valletw/busy-board/busy-board.step

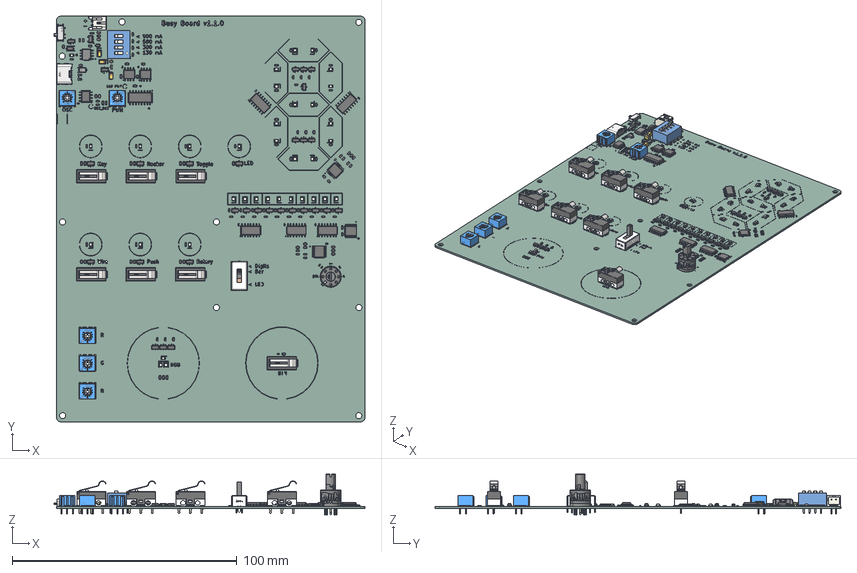
[picture p3: CAD file, 2026-09-27]
busy-board.step
138.2 x 180.3 x 18.1 mm
R_0402_1005Metric x 3
CP_EIA-3216-18_Kemet-A x 3
LED_0805_2012Metric x 35
C_0402_1005Metric x 14
SW-TH_RS-08-300-150GF
SW-TH_RT-0C4-D
R_0603_1608Metric x 108
SOT-23 x 28
TYPE-C-SMD_6P-L8.9-W6.8-H3.2-P1.00
TPD1E05U06DPYR x 2
TP4056-42-ESOP8
SW-TH_DM1-12UP-1-L12.8-W5.8-H11.3-P5.08 x 7
SW-TH_SS-23D06-L5
C_0603_1608Metric x 6
L_0603_1608Metric x 2
SOIC-14_3.9x8.7mm_P1.27mm x 5
D_SOD-123F
BOURNS_3362P x 5
TSSOP-16_4.4x5mm_P0.65mm x 3
SW-SMD_3P-L6.6-W2.7-LS7.8-P1.50
SOT-23-3
D_SMF
SW_DIP_SPSTx04_Slide_9.78x12.34mm_W7.62mm_P2.54mm
JST_PH_S2B-PH-K_1x02_P2.00mm_Horizontal
SOIC-8_3.9x4.9mm_P1.27mm x 3
SOP-16_4.4x10.4mm_P1.27mm
SOT-23-5
D_SOD-323
busy-board_silkscreen
busy-board_PCB
