valletw/busy-board/busy-board.pdf

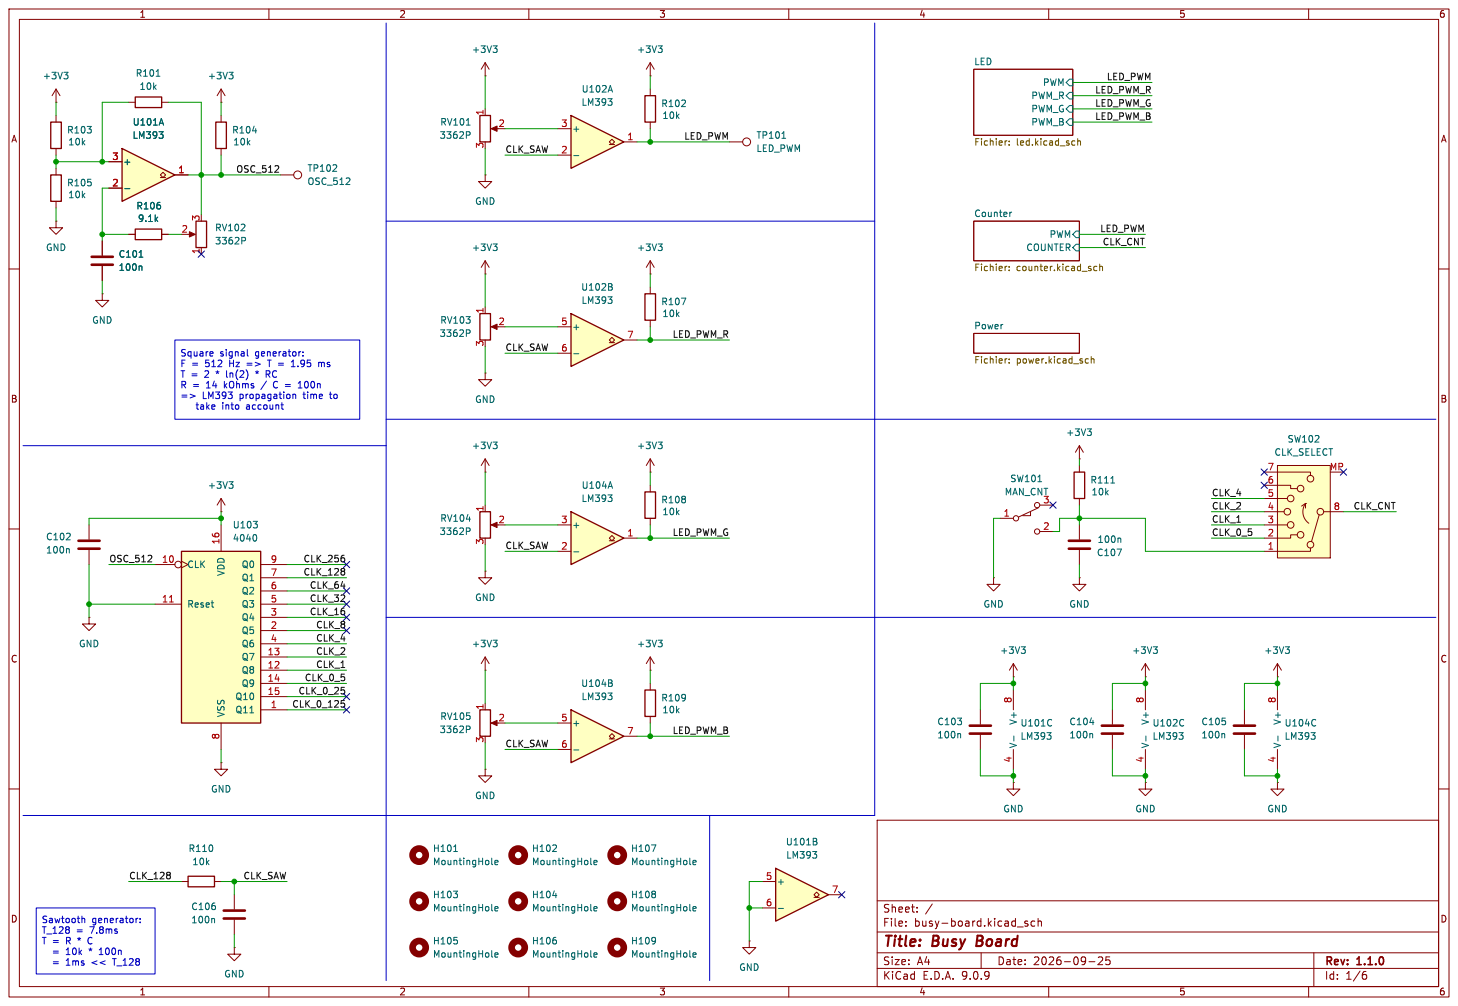
[picture p4: page 1]

LED
Power Fichier: power.kicad_sch PWM

Square signal generator: F = 512 Hz => T = 1.95 ms T = 2 * ln(2) * RC

File: busy-board.kicad_sch Sheet: /
Id: 1/6 Title: Busy Board

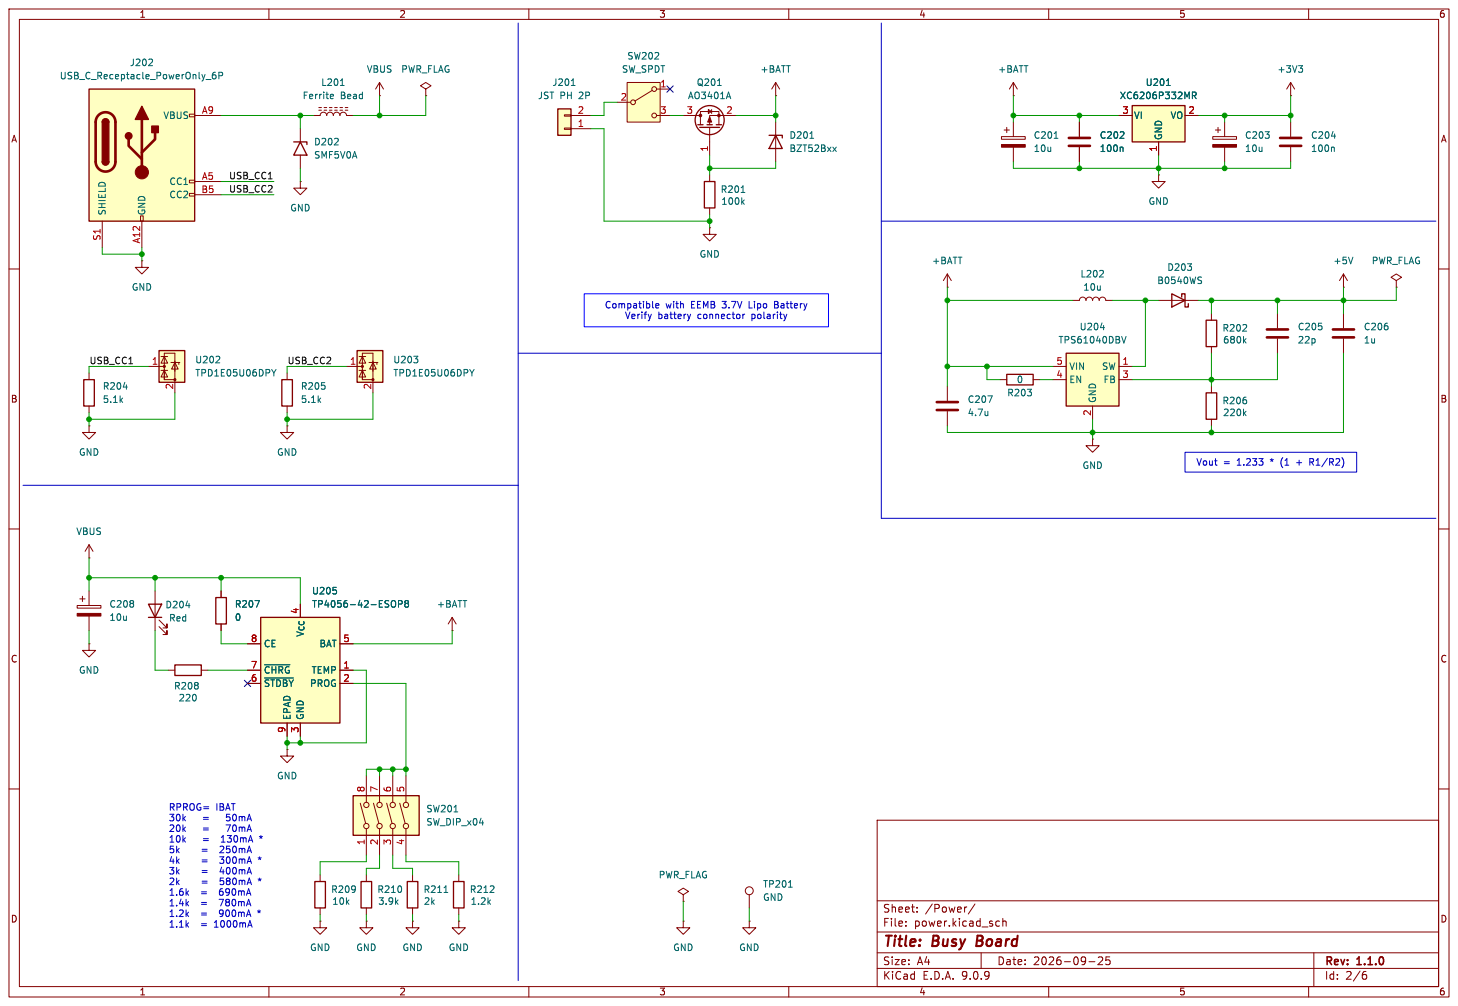
[picture p5: page 2]

File: power.kicad_sch Sheet: /Power/
Id: 2/6 Title: Busy Board

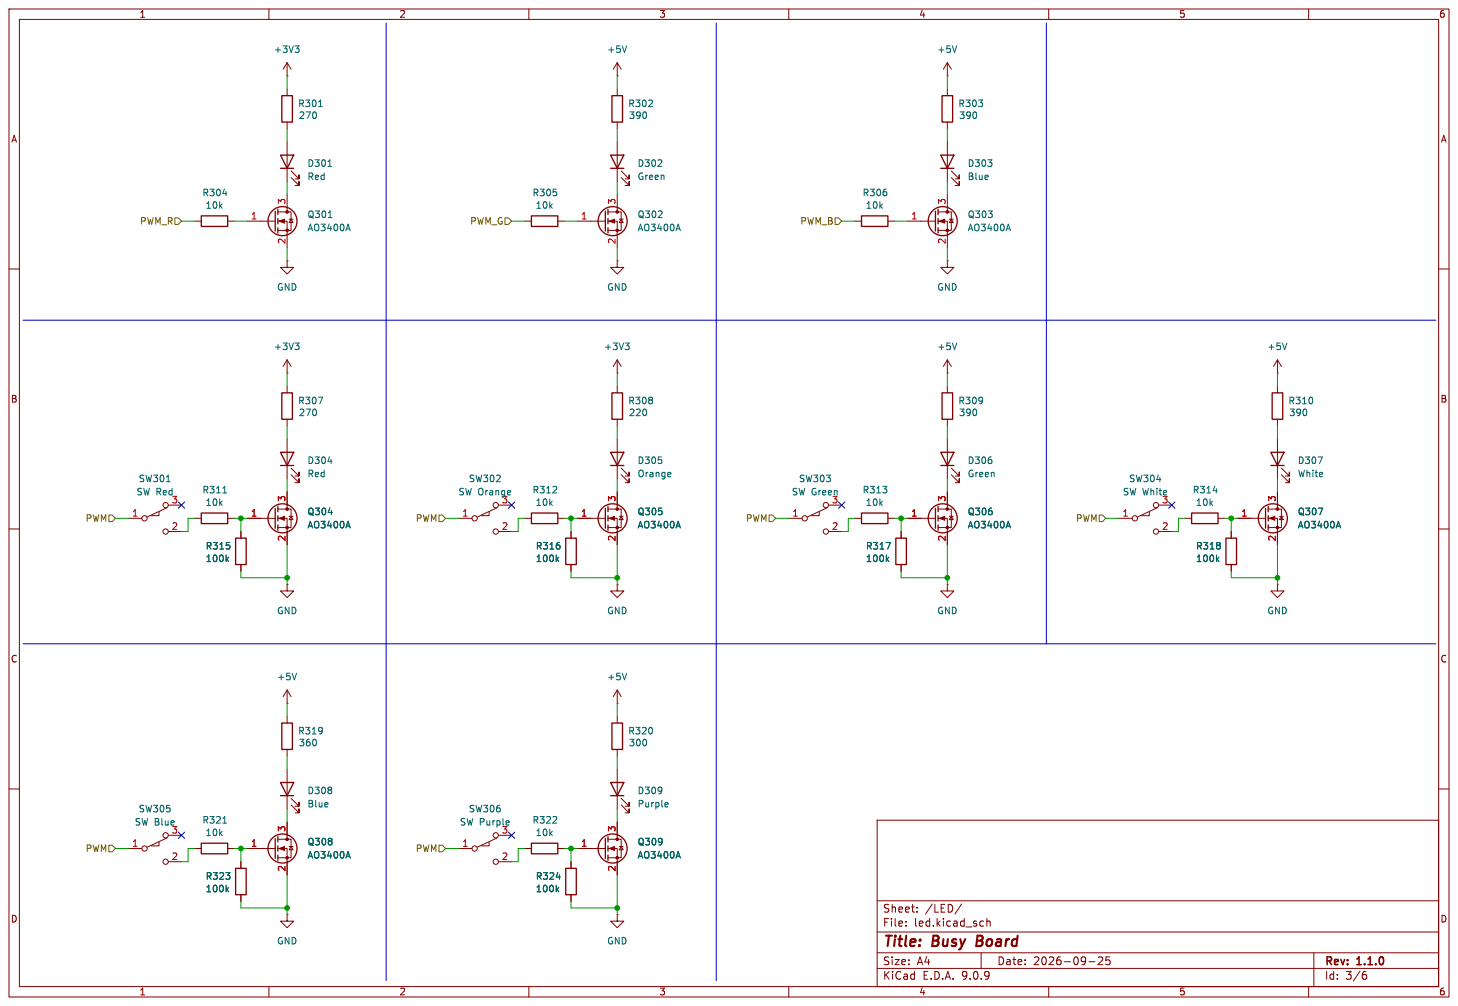
[picture p6: page 3]

File: led.kicad_sch Sheet: /LED/
Id: 3/6 Title: Busy Board

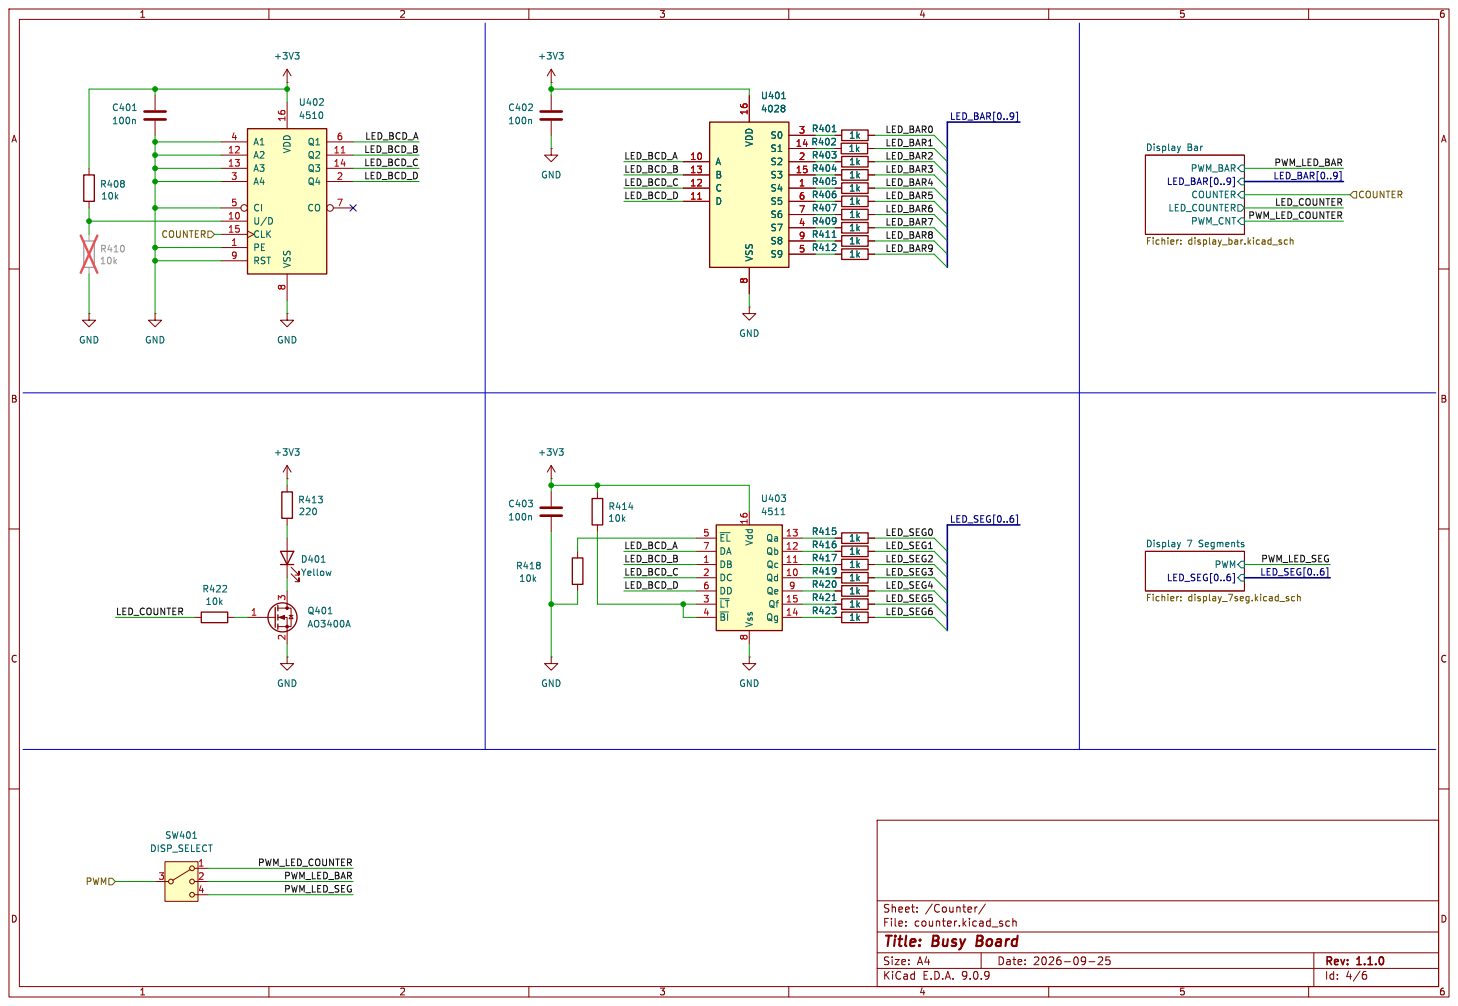
[picture p7: page 4]

PWM_CNT Display Bar Fichier: display_bar.kicad_sch PWM

File: counter.kicad_sch Sheet: /Counter/
Id: 4/6 Title: Busy Board

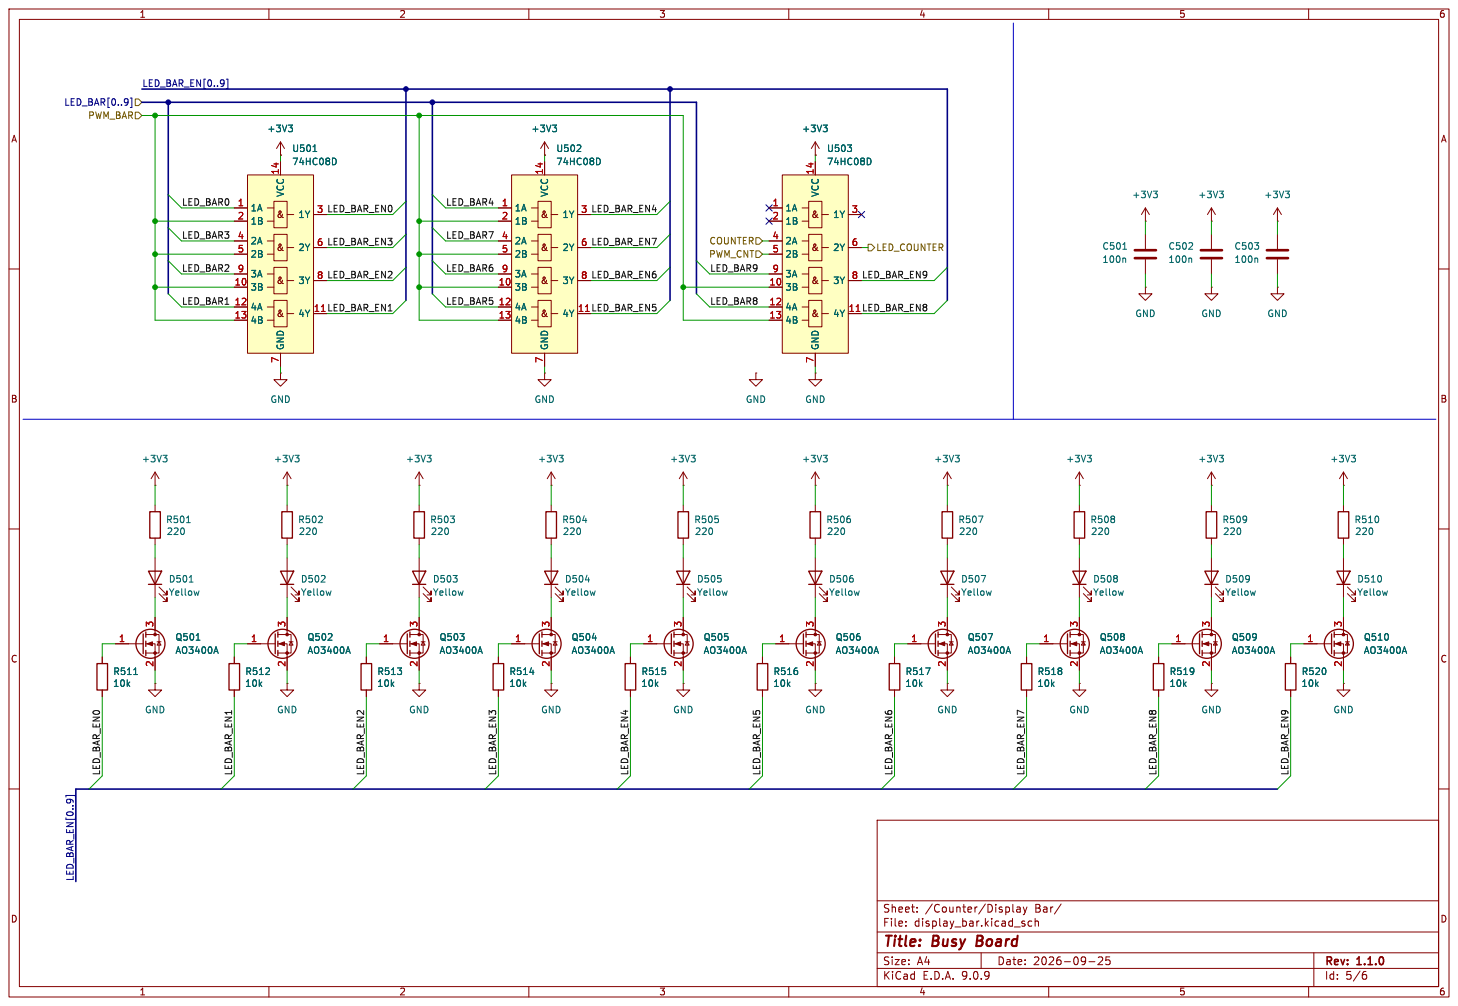
[picture p8: page 5]

Id: 5/6 Title: Busy Board

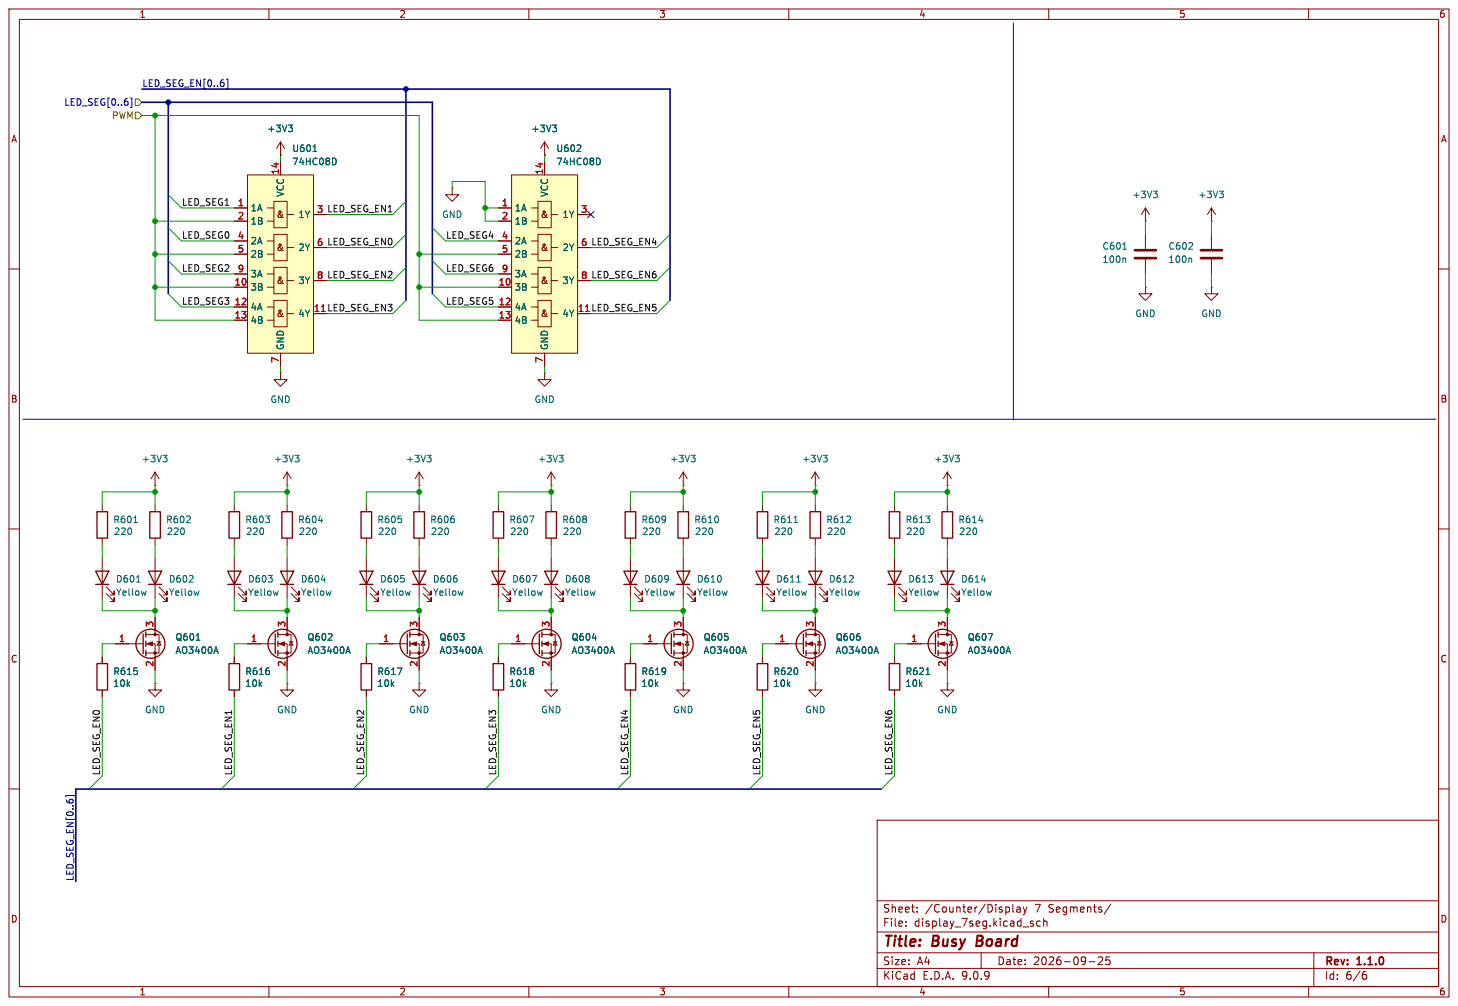
[picture p9: page 6]

Id: 6/6 Title: Busy Board
