valletw/busy-board/kicad/busy-board.kicad_pcb

## KiCad design kicad/busy-board.kicad_pcb (2026-09-27)

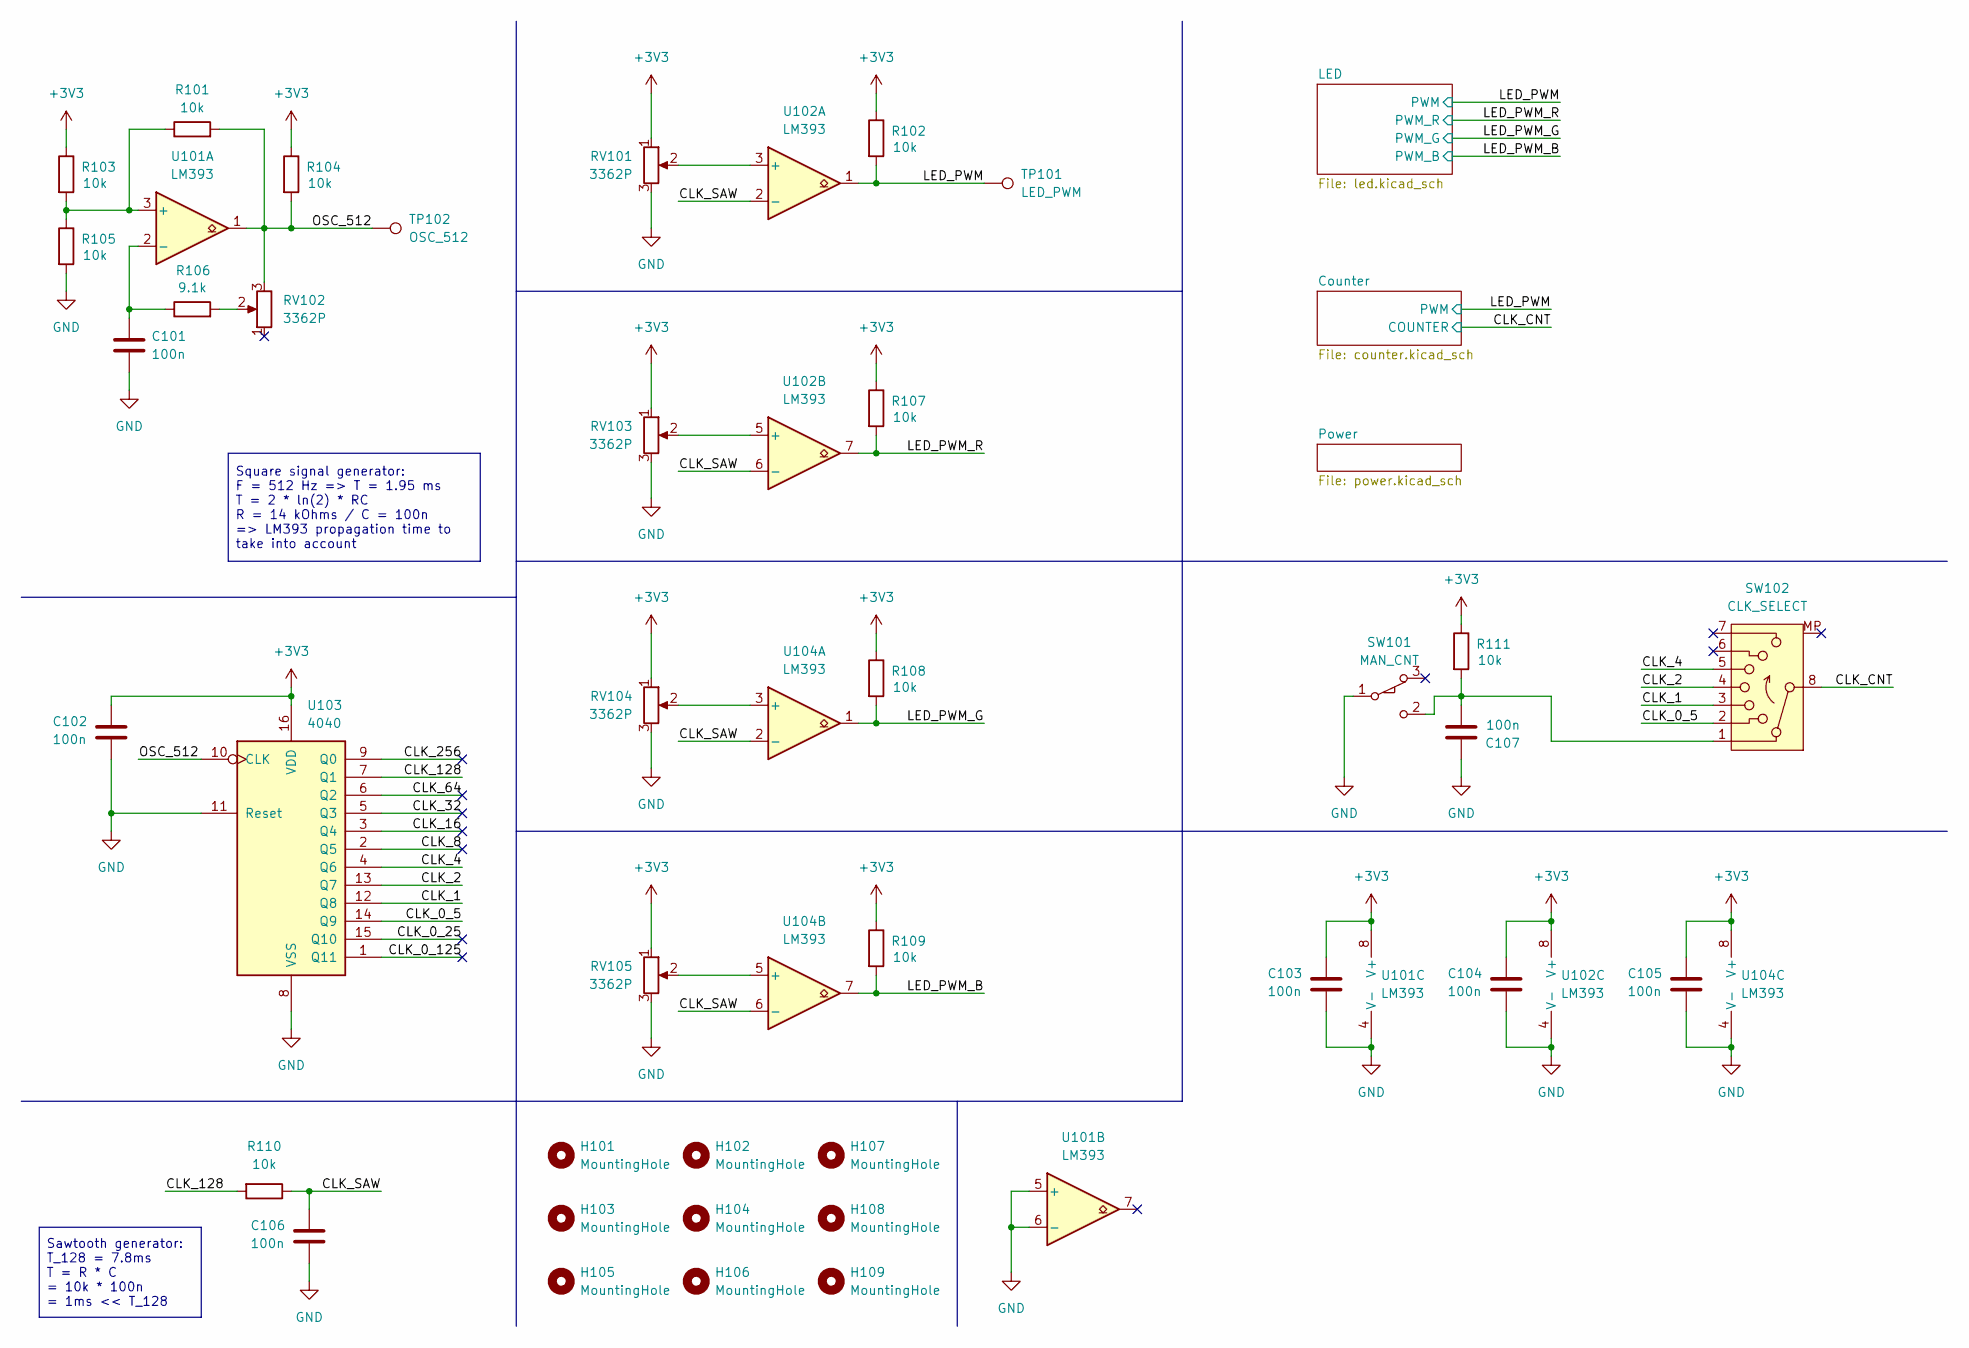
[picture p10: schematic busy-board.kicad_sch, Busy Board]

Parts:
C101: 100n; C_0603_1608Metric; MFR Part # CC0603JRX7R7BB104; LCSC Part # C91183
C102, C103, C104, C105, C106, C107: 100n; C_0402_1005Metric; MFR Part # CL05B104KB54PNC; LCSC Part # C307331
H101, H102, H103, H104, H105, H106, H107, H108, H109: MountingHole; MountingHole_2.7mm_M2.5_ISO7380
R101, R102, R103, R104, R105, R107, R108, R109, R110, R111: 10k; R_0603_1608Metric; MFR Part # 0603WAF1002T5E; LCSC Part # C25804
R106: 9.1k; R_0603_1608Metric; MFR Part # 0603WAF9101T5E; LCSC Part # C23260
RV101, RV102, RV103, RV104, RV105: 3362P; BOURNS_3362P; MFR Part # 3362P-1-103LF; LCSC Part # C58159
SW101: MAN_CNT; SW-TH_DM1-12UP-1; MFR Part # DM1-12UP-1; LCSC Part # C405949
SW102: CLK_SELECT; SW-TH_RT-0C4-D; MFR Part # RT-0C5; LCSC Part # C508440
TP101: LED_PWM; TestPoint_Pad_D1.5mm
TP102: OSC_512; TestPoint_Pad_D1.5mm
U101, U102, U104: LM393; SOIC-8_3.9x4.9mm_P1.27mm; MFR Part # LM393DR2G; LCSC Part # C7955
U103: 4040; SOP-16_4.4x10.4mm_P1.27mm; MFR Part # CD4040BM/TR; LCSC Part # C725347

Connections:
+3V3: C102.1, C103.1, C104.1, C105.1, R102.1, R103.1, R104.1, R107.1, R108.1, R109.1, R111.1, RV101.1, RV103.1, RV104.1, RV105.1, U101.8 (V+), U102.8 (V+), U103.16 (VDD), U104.8 (V+); also elsewhere on the board
/CLK_0_5: SW102.2, U103.14 (Q9)
/CLK_0_25: U103.15 (Q10)
/CLK_0_125: U103.1 (Q11)
/CLK_1: SW102.3, U103.12 (Q8)
/CLK_2: SW102.4, U103.13 (Q7)
/CLK_4: SW102.5, U103.4 (Q6)
/CLK_8: U103.2 (Q5)
/CLK_16: U103.3 (Q4)
/CLK_32: U103.5 (Q3)
/CLK_64: U103.6 (Q2)
/CLK_128: R110.2, U103.7 (Q1)
/CLK_256: U103.9 (Q0)
/CLK_CNT: SW102.8; also elsewhere on the board
/CLK_SAW: C106.1, R110.1, U102.2 (-), U102.6 (-), U104.2 (-), U104.6 (-)
/LED_PWM: R102.2, TP101.1, U102.1; also elsewhere on the board
/LED_PWM_B: R109.2, U104.7; also elsewhere on the board
/LED_PWM_G: R108.2, U104.1; also elsewhere on the board
/LED_PWM_R: R107.2, U102.7; also elsewhere on the board
/OSC_512: R101.2, R104.2, RV102.3, TP102.1, U101.1, U103.10 (CLK)
GND: C101.2, C102.2, C103.2, C104.2, C105.2, C106.2, C107.1, R105.2, RV101.3, RV103.3, RV104.3, RV105.3, SW101.1 (A), U101.4 (V-), U101.5 (+), U101.6 (-), U102.4 (V-), U103.8 (VSS), U103.11 (Reset), U104.4 (V-); also elsewhere on the board
unnamed: R106.2, RV102.2
unnamed: C107.2, R111.2, SW101.2 (B), SW102.1
unnamed: R101.1, R103.2, R105.1, U101.3 (+)
unnamed: C101.1, R106.1, U101.2 (-)
unnamed: RV101.2, U102.3 (+)
unnamed: RV103.2, U102.5 (+)
unnamed: RV104.2, U104.3 (+)
unnamed: RV105.2, U104.5 (+)

Notes on the sheet:
Sawtooth generator: T_128 = 7.8ms T = R * C = 10k * 100n = 1ms << T_128
Square signal generator: F = 512 Hz => T = 1.95 ms T = 2 * ln(2) * RC R = 14 kOhms / C = 100n => LM393 propagation time to take into account

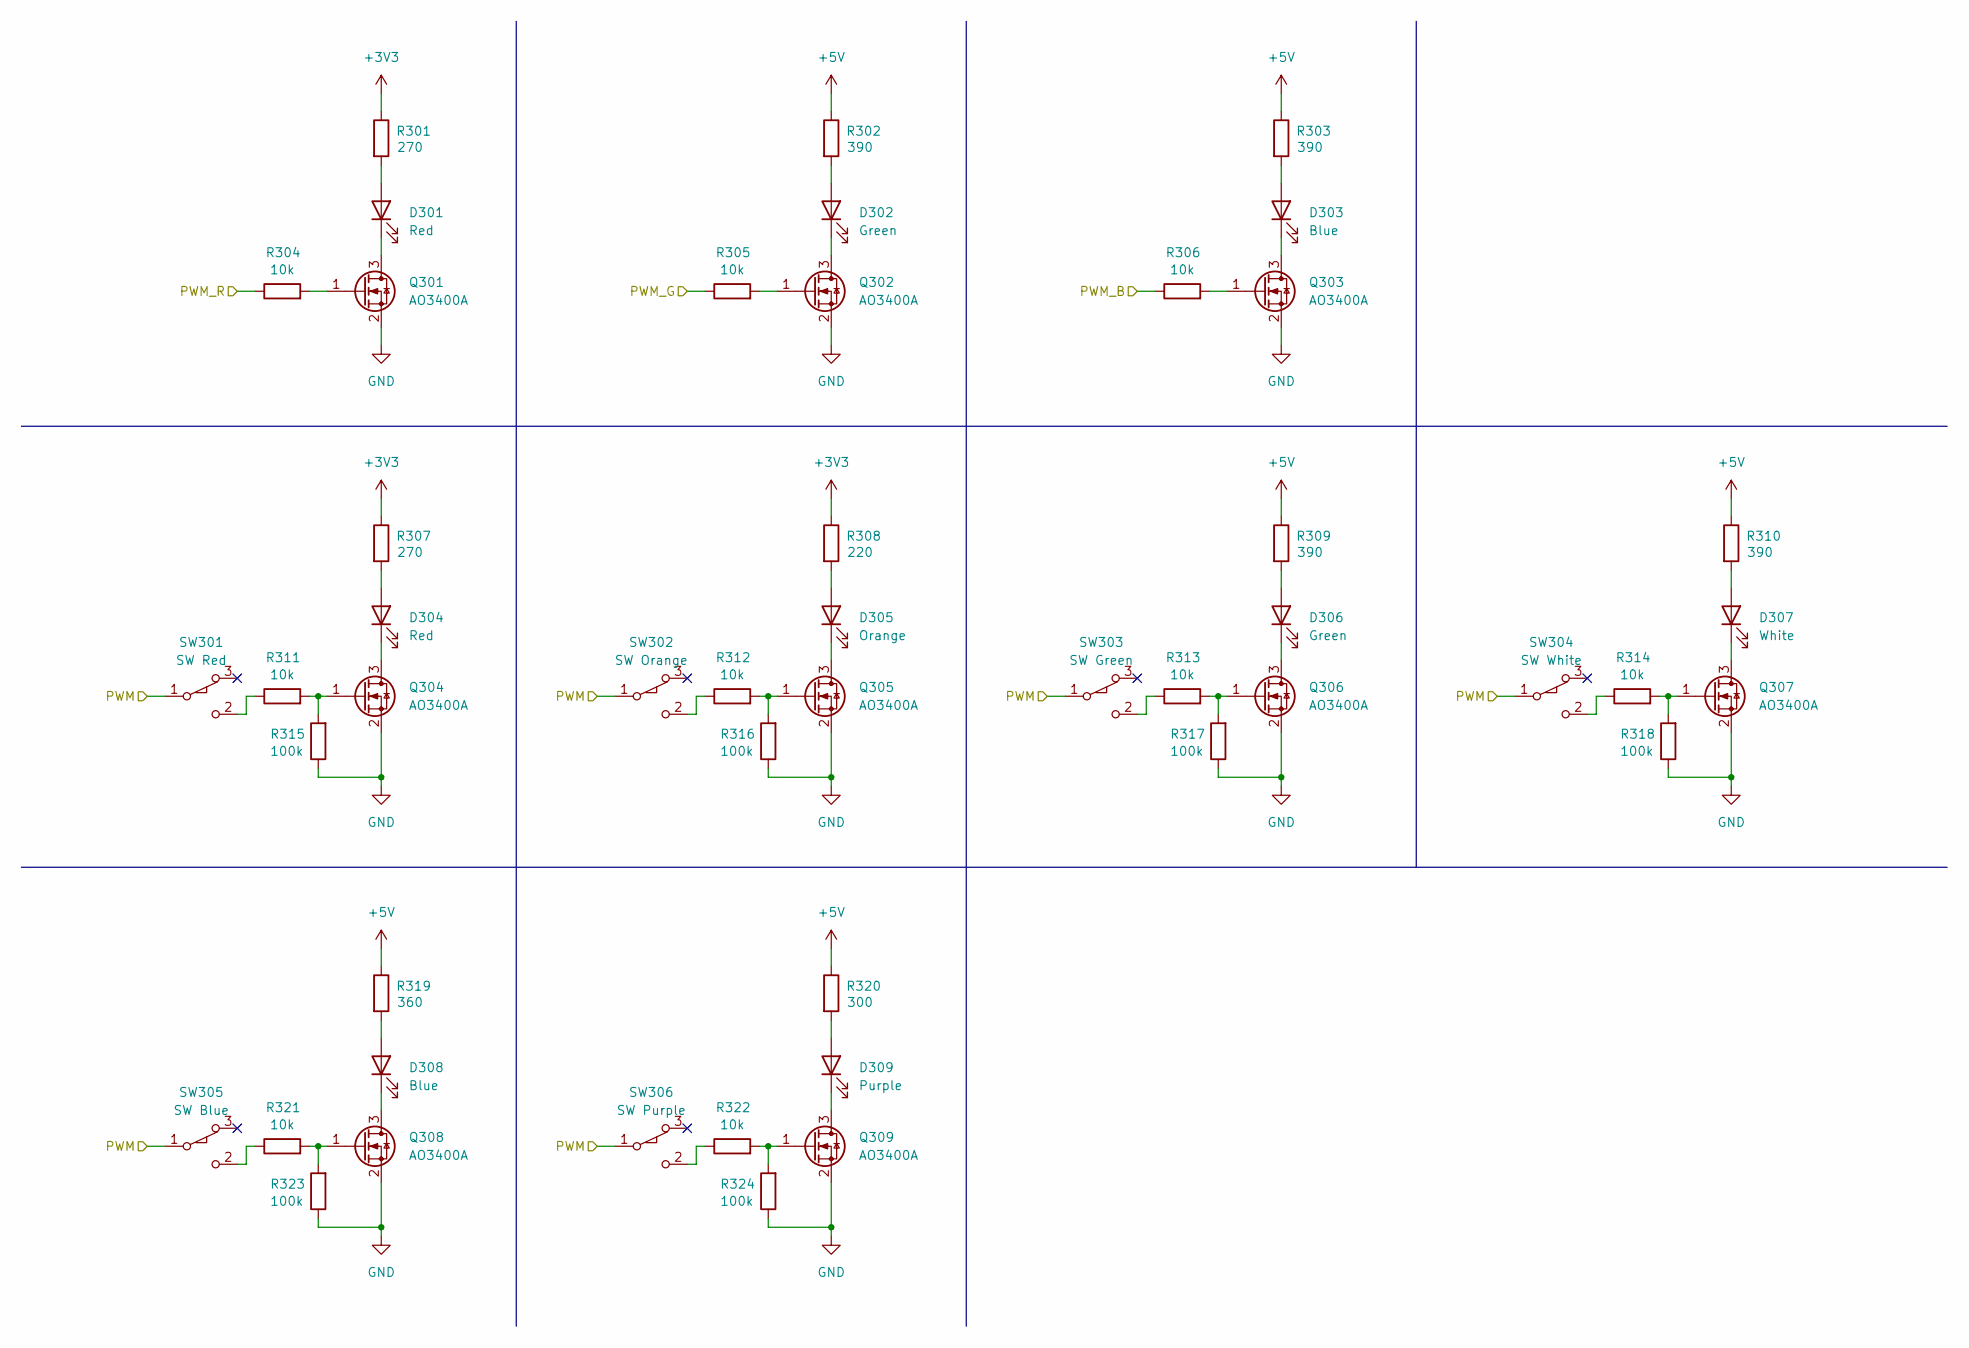
[picture p11: schematic led.kicad_sch, Busy Board]

Parts:
D301, D304: Red; LED_0805_2012Metric; MFR Part # NCD0805R1; LCSC Part # C84256
D302, D306: Green; LED_0805_2012Metric; MFR Part # KT-0805G; LCSC Part # C2297
D303, D308: Blue; LED_0805_2012Metric; MFR Part # NCD0805B2; LCSC Part # C84259
D305: Orange; LED_0805_2012Metric; MFR Part # NCD0805O1; LCSC Part # C84262
D307: White; LED_0805_2012Metric; MFR Part # KT-0805W; LCSC Part # C34499
D309: Purple; LED_0805_2012Metric; MFR Part # XL-2012UVA; LCSC Part # C7371915
Q301, Q302, Q303, Q304, Q305, Q306, Q307, Q308, Q309: AO3400A; SOT-23; MFR Part # AO3400A; LCSC Part # C20917
R301, R307: 270; R_0603_1608Metric; MFR Part # 0603WAF2700T5E; LCSC Part # C22966
R302, R303, R309, R310: 390; R_0603_1608Metric; MFR Part # 0603WAF3900T5E; LCSC Part # C23151
R304, R305, R306, R311, R312, R313, R314, R321, R322: 10k; R_0603_1608Metric; MFR Part # 0603WAF1002T5E; LCSC Part # C25804
R308: 220; R_0603_1608Metric; MFR Part # 0603WAF2200T5E; LCSC Part # C22962
R315, R316, R317, R318, R323, R324: 100k; R_0603_1608Metric; MFR Part # 0603WAF1003T5E; LCSC Part # C25803
R319: 360; R_0603_1608Metric; MFR Part # 0603WAF3600T5E; LCSC Part # C25194
R320: 300; R_0603_1608Metric; MFR Part # 0603WAF3000T5E; LCSC Part # C23025
SW301: SW Red; SW-TH_DM1-12UP-1; MFR Part # DM1-12UP-1; LCSC Part # C405949
SW302: SW Orange; SW-TH_DM1-12UP-1; MFR Part # DM1-12UP-1; LCSC Part # C405949
SW303: SW Green; SW-TH_DM1-12UP-1; MFR Part # DM1-12UP-1; LCSC Part # C405949
SW304: SW White; SW-TH_DM1-12UP-1; MFR Part # DM1-12UP-1; LCSC Part # C405949
SW305: SW Blue; SW-TH_DM1-12UP-1; MFR Part # DM1-12UP-1; LCSC Part # C405949
SW306: SW Purple; SW-TH_DM1-12UP-1; MFR Part # DM1-12UP-1; LCSC Part # C405949

Connections:
+3V3: R301.1, R307.1, R308.1; also elsewhere on the board
+5V: R302.1, R303.1, R309.1, R310.1, R319.1, R320.1; also elsewhere on the board
/LED_PWM: SW301.1 (A), SW302.1 (A), SW303.1 (A), SW304.1 (A), SW305.1 (A), SW306.1 (A); also elsewhere on the board
/LED_PWM_B: R306.1; also elsewhere on the board
/LED_PWM_G: R305.1; also elsewhere on the board
/LED_PWM_R: R304.1; also elsewhere on the board
GND: Q301.2 (S), Q302.2 (S), Q303.2 (S), Q304.2 (S), Q305.2 (S), Q306.2 (S), Q307.2 (S), Q308.2 (S), Q309.2 (S), R315.1, R316.1, R317.1, R318.1, R323.1, R324.1; also elsewhere on the board
unnamed: D301.2 (A), R301.2
unnamed: D301.1 (K), Q301.3 (D)
unnamed: D302.2 (A), R302.2
unnamed: D302.1 (K), Q302.3 (D)
unnamed: D303.2 (A), R303.2
unnamed: D303.1 (K), Q303.3 (D)
unnamed: D304.2 (A), R307.2
unnamed: D304.1 (K), Q304.3 (D)
unnamed: D305.2 (A), R308.2
unnamed: D305.1 (K), Q305.3 (D)
unnamed: D306.2 (A), R309.2
unnamed: D306.1 (K), Q306.3 (D)
unnamed: D307.2 (A), R310.2
unnamed: D307.1 (K), Q307.3 (D)
unnamed: D308.2 (A), R319.2
unnamed: D308.1 (K), Q308.3 (D)
unnamed: D309.2 (A), R320.2
unnamed: D309.1 (K), Q309.3 (D)
unnamed: Q301.1 (G), R304.2
unnamed: Q302.1 (G), R305.2
unnamed: Q303.1 (G), R306.2
unnamed: Q304.1 (G), R311.2, R315.2
unnamed: Q305.1 (G), R312.2, R316.2
unnamed: Q306.1 (G), R313.2, R317.2
unnamed: Q307.1 (G), R314.2, R318.2
unnamed: Q308.1 (G), R321.2, R323.2
unnamed: Q309.1 (G), R322.2, R324.2
unnamed: R311.1, SW301.2 (B)
unnamed: R312.1, SW302.2 (B)
unnamed: R313.1, SW303.2 (B)
unnamed: R314.1, SW304.2 (B)
unnamed: R321.1, SW305.2 (B)
unnamed: R322.1, SW306.2 (B)

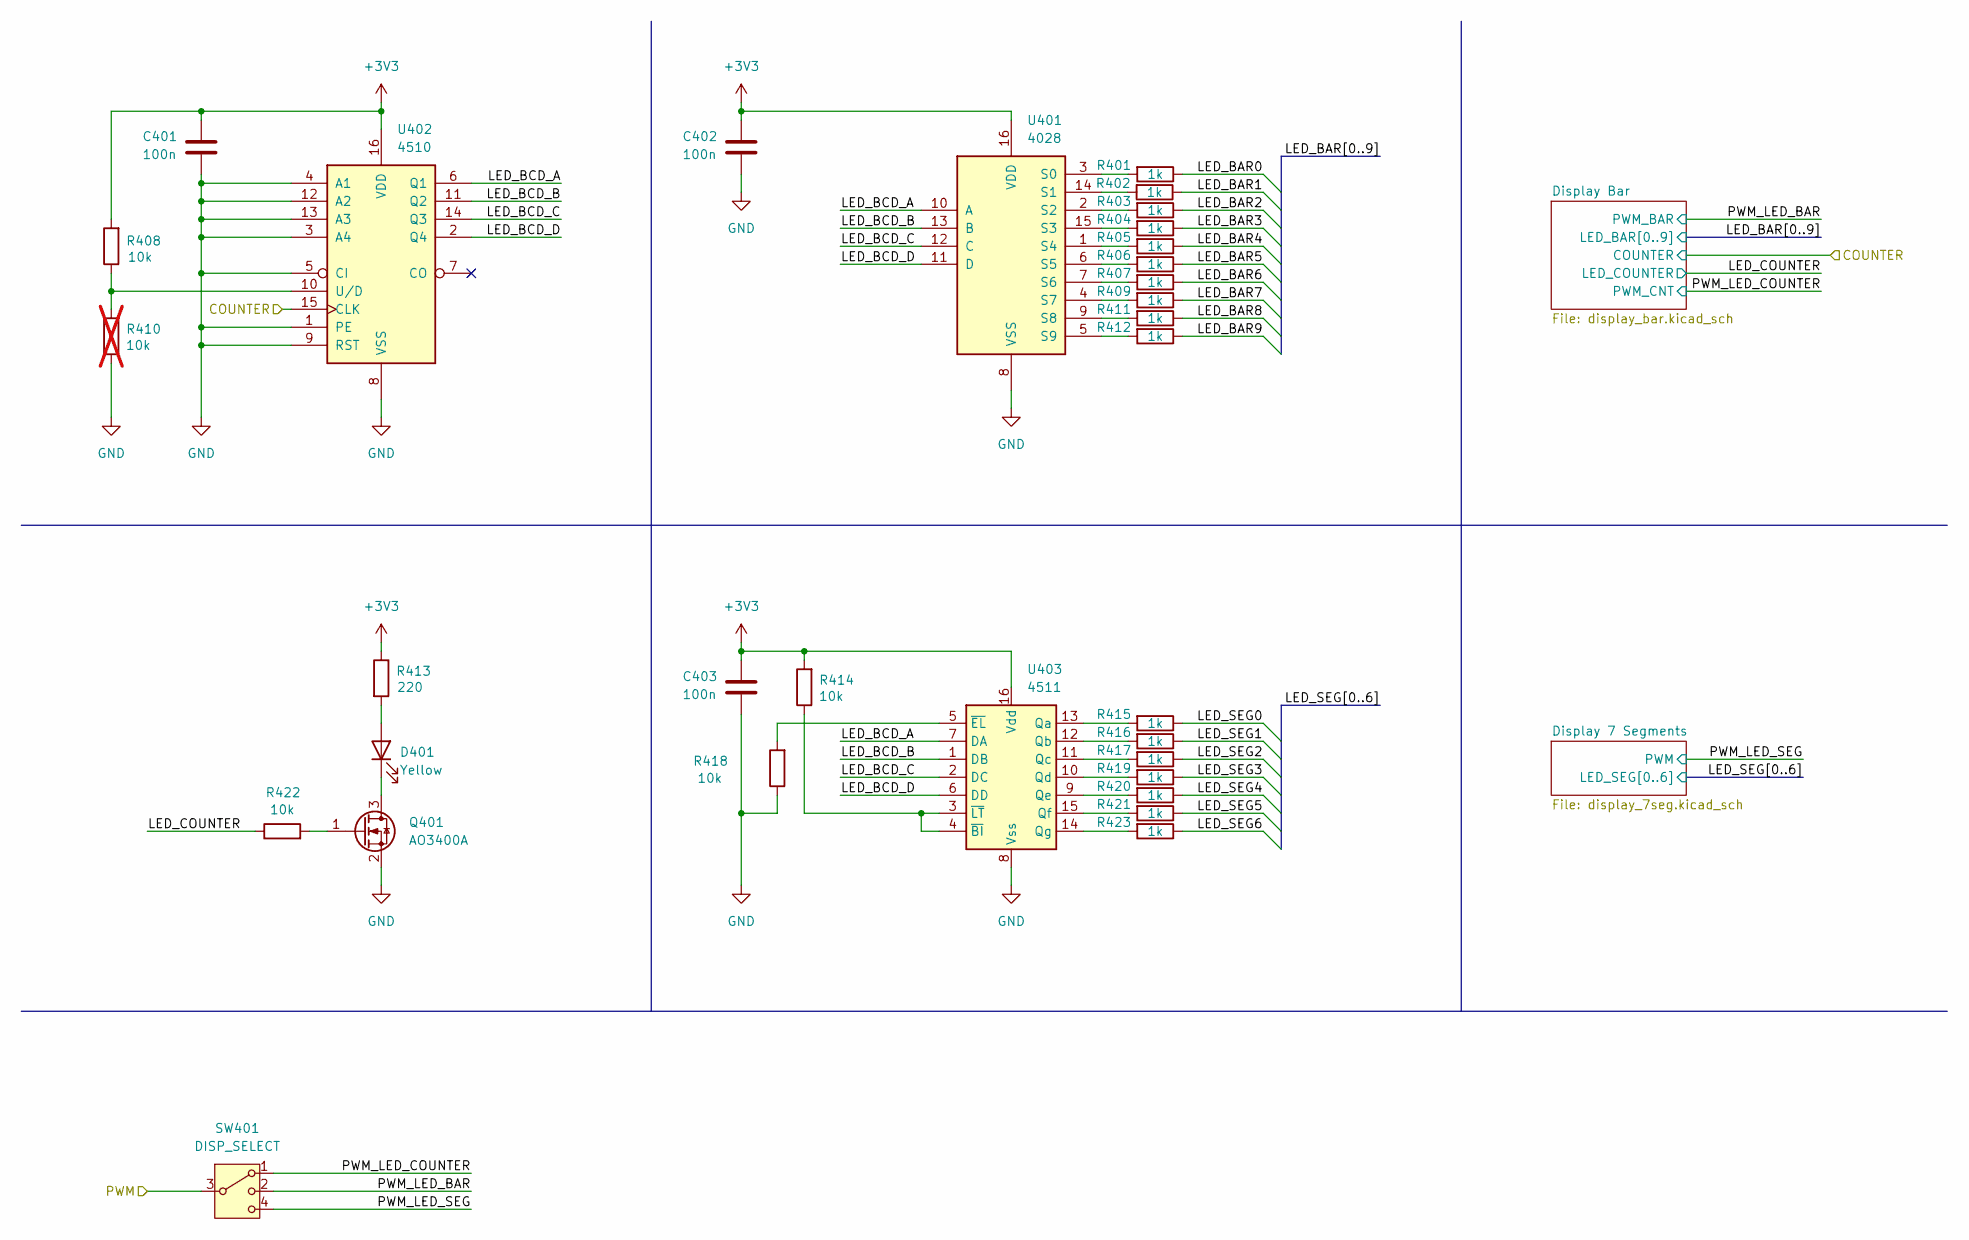
[picture p12: schematic counter.kicad_sch, Busy Board]

Parts:
C401, C402, C403: 100n; C_0402_1005Metric; MFR Part # CL05B104KB54PNC; LCSC Part # C307331
D401: Yellow; LED_0805_2012Metric; MFR Part # KT-0805Y; LCSC Part # C2296
Q401: AO3400A; SOT-23; MFR Part # AO3400A; LCSC Part # C20917
R401, R402, R403, R404, R405, R406, R407, R409, R411, R412, R415, R416, R417, R419, R420, R421, R423: 1k; R_0603_1608Metric; MFR Part # 0603WAF1001T5E; LCSC Part # C21190
R408, R414, R418, R422: 10k; R_0603_1608Metric; MFR Part # 0603WAF1002T5E; LCSC Part # C25804
R410: 10k; R_0603_1608Metric; MFR Part # 0603WAF1002T5E; LCSC Part # C25804; not fitted
R413: 220; R_0603_1608Metric; MFR Part # 0603WAF2200T5E; LCSC Part # C22962
SW401: DISP_SELECT; SW-TH_SS-23D06-L5; MFR Part # SS23D06L5; LCSC Part # C609829
U401: 4028; TSSOP-16_4.4x5mm_P0.65mm; MFR Part # CD4028BPWR; LCSC Part # C2653282
U402: 4510; TSSOP-16_4.4x5mm_P0.65mm; MFR Part # CD4510BPWR; LCSC Part # C2862976
U403: 4511; TSSOP-16_4.4x5mm_P0.65mm; MFR Part # CD4511BPWR; LCSC Part # C353987

Connections:
+3V3: C401.1, C402.1, C403.1, R408.2, R413.1, R414.2, U401.16 (VDD), U402.16 (VDD), U403.16 (Vdd); also elsewhere on the board
/CLK_CNT: U402.15 (CLK); also elsewhere on the board
/Counter/LED_BAR0: R401.1; also elsewhere on the board
/Counter/LED_BAR1: R402.1; also elsewhere on the board
/Counter/LED_BAR2: R403.1; also elsewhere on the board
/Counter/LED_BAR3: R404.1; also elsewhere on the board
/Counter/LED_BAR4: R405.1; also elsewhere on the board
/Counter/LED_BAR5: R406.1; also elsewhere on the board
/Counter/LED_BAR6: R407.1; also elsewhere on the board
/Counter/LED_BAR7: R409.1; also elsewhere on the board
/Counter/LED_BAR8: R411.1; also elsewhere on the board
/Counter/LED_BAR9: R412.1; also elsewhere on the board
/Counter/LED_BCD_A: U401.10 (A), U402.6 (Q1), U403.7 (DA)
/Counter/LED_BCD_B: U401.13 (B), U402.11 (Q2), U403.1 (DB)
/Counter/LED_BCD_C: U401.12 (C), U402.14 (Q3), U403.2 (DC)
/Counter/LED_BCD_D: U401.11 (D), U402.2 (Q4), U403.6 (DD)
/Counter/LED_COUNTER: R422.1; also elsewhere on the board
/Counter/LED_SEG0: R415.1; also elsewhere on the board
/Counter/LED_SEG1: R416.1; also elsewhere on the board
/Counter/LED_SEG2: R417.1; also elsewhere on the board
/Counter/LED_SEG3: R419.1; also elsewhere on the board
/Counter/LED_SEG4: R420.1; also elsewhere on the board
/Counter/LED_SEG5: R421.1; also elsewhere on the board
/Counter/LED_SEG6: R423.1; also elsewhere on the board
/Counter/PWM_LED_BAR: SW401.2; also elsewhere on the board
/Counter/PWM_LED_COUNTER: SW401.1; also elsewhere on the board
/Counter/PWM_LED_SEG: SW401.4; also elsewhere on the board
/LED_PWM: SW401.3; also elsewhere on the board
GND: C401.2, C402.2, C403.2, Q401.2 (S), R410.1, R418.1, U401.8 (VSS), U402.1 (PE), U402.3 (A4), U402.4 (A1), U402.5 (CI), U402.8 (VSS), U402.9 (RST), U402.12 (A2), U402.13 (A3), U403.8 (Vss); also elsewhere on the board
unnamed: D401.2 (A), R413.2
unnamed: D401.1 (K), Q401.3 (D)
unnamed: Q401.1 (G), R422.2
unnamed: R401.2, U401.3 (S0)
unnamed: R402.2, U401.14 (S1)
unnamed: R403.2, U401.2 (S2)
unnamed: R404.2, U401.15 (S3)
unnamed: R405.2, U401.1 (S4)
unnamed: R406.2, U401.6 (S5)
unnamed: R407.2, U401.7 (S6)
unnamed: R409.2, U401.4 (S7)
unnamed: R411.2, U401.9 (S8)
unnamed: R412.2, U401.5 (S9)
unnamed: R408.1, R410.2, U402.10 (U/D)
unnamed: R415.2, U403.13 (Qa)
unnamed: R416.2, U403.12 (Qb)
unnamed: R417.2, U403.11 (Qc)
unnamed: R419.2, U403.10 (Qd)
unnamed: R420.2, U403.9 (Qe)
unnamed: R421.2, U403.15 (Qf)
unnamed: R423.2, U403.14 (Qg)
unnamed: R414.1, U403.3 (~LT), U403.4 (~BI)
unnamed: R418.2, U403.5 (~EL)

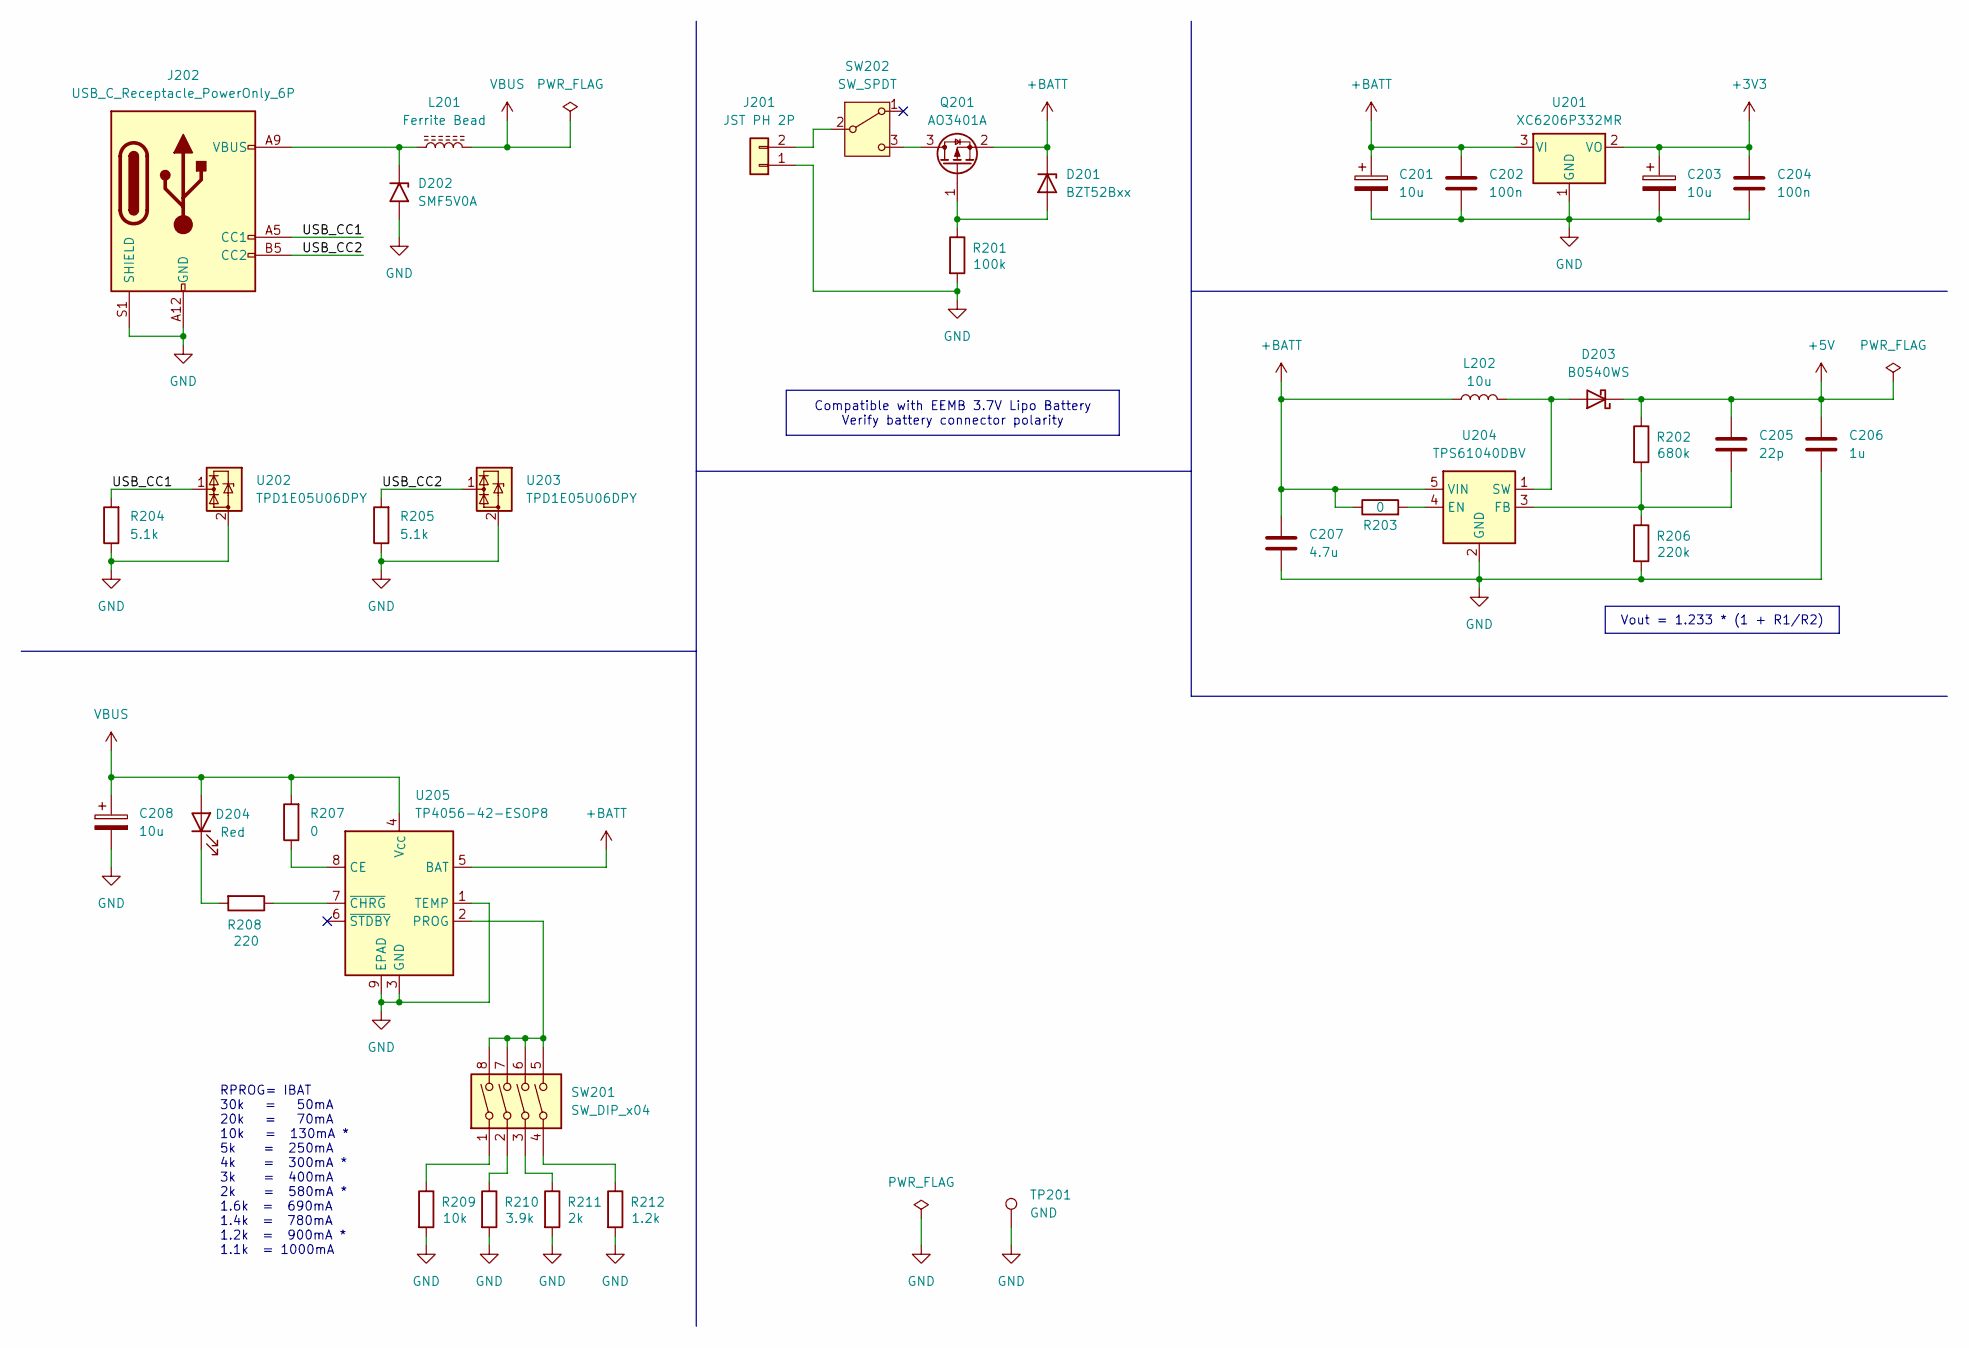
[picture p13: schematic power.kicad_sch, Busy Board]

Parts:
C201, C203, C208: 10u; CP_EIA-3216-18_Kemet-A; MFR Part # TAJA106K016RNJ; LCSC Part # C7171
C202, C204: 100n; C_0603_1608Metric; MFR Part # CC0603KRX7R9BB104; LCSC Part # C14663
C205: 22p; C_0603_1608Metric; MFR Part # CL10C220JB8NNNC; LCSC Part # C1653
C206: 1u; C_0603_1608Metric; MFR Part # CL10A105KB8NNNC; LCSC Part # C15849
C207: 4.7u; C_0603_1608Metric; MFR Part # CL10A475KO8NNNC; LCSC Part # C19666
D201: BZT52Bxx; D_SOD-123F; MFR Part # BZT52B5V1; LCSC Part # C19077393
D202: SMF5V0A; D_SMF; MFR Part # SMF5.0A; LCSC Part # C19077497
D203: B0540WS; D_SOD-323; MFR Part # B0540WS; LCSC Part # C7420326
D204: Red; LED_0805_2012Metric; MFR Part # NCD0805R1; LCSC Part # C84256
J201: JST PH 2P; JST_PH_S2B-PH-K_1x02_P2.00mm_Horizontal; MFR Part # S2B-PH-K-S(LF)(SN); LCSC Part # C173752
J202: USB_C_Receptacle_PowerOnly_6P; USB_C_Receptacle_HRO_TYPE-C-31-M-17; MFR Part # TYPE-C-31-M-17; LCSC Part # C283540
L201: Ferrite Bead; L_0603_1608Metric; MFR Part # BLM18PG121SN1D; LCSC Part # C14709
L202: 10u; L_0603_1608Metric; MFR Part # SDFL1608S100KTF; LCSC Part # C1035
Q201: AO3401A; SOT-23; MFR Part # AO3401A; LCSC Part # C15127
R201: 100k; R_0603_1608Metric; MFR Part # 0603WAF1003T5E; LCSC Part # C25803
R202: 680k; R_0603_1608Metric; MFR Part # 0603WAF6803T5E; LCSC Part # C25822
R203, R207: 0; R_0603_1608Metric; MFR Part # 0603WAF0000T5E; LCSC Part # C21189
R204, R205: 5.1k; R_0402_1005Metric; MFR Part # 0402WGF5101TCE; LCSC Part # C25905
R206: 220k; R_0603_1608Metric; MFR Part # 0603WAF2203T5E; LCSC Part # C22961
R208: 220; R_0402_1005Metric; MFR Part # 0402WGF5101TCE; LCSC Part # C25905
R209: 10k; R_0603_1608Metric; MFR Part # 0603WAF1002T5E; LCSC Part # C25804
R210: 3.9k; R_0603_1608Metric; MFR Part # 0603WAF3901T5E; LCSC Part # C23018
R211: 2k; R_0603_1608Metric; MFR Part # 0603WAF2001T5E; LCSC Part # C22975
R212: 1.2k; R_0603_1608Metric; MFR Part # 0603WAF1201T5E; LCSC Part # C22765
SW201: SW_DIP_x04; SW_DIP_SPSTx04_Slide_9.78x12.34mm_W7.62mm_P2.54mm; MFR Part # DSWB04LHGET; LCSC Part # C99418
SW202: SW_SPDT; SW_SPDT_Shouhan_MSK12C02; MFR Part # MSK12C02; LCSC Part # C431540
TP201: GND; TestPoint_Pad_4.0x4.0mm
U201: XC6206P332MR; SOT-23-3; MFR Part # XC6206P332MR-G; LCSC Part # C5446
U202, U203: TPD1E05U06DPY; Texas_DPY0002A_0.6x1mm_P0.65mm; MFR Part # TPD1E05U06DPYT; LCSC Part # C1847651
U204: TPS61040DBV; SOT-23-5; MFR Part # TPS61040DBVR; LCSC Part # C7722
U205: TP4056-42-ESOP8; MFR Part # TP4056-42-ESOP8; LCSC Part # C16581

Connections:
+3V3: C203.1, C204.1, U201.2 (VO); also elsewhere on the board
+5V: C205.1, C206.1, D203.1 (K), R202.1; also elsewhere on the board
+BATT: C201.1, C202.1, C207.1, D201.1 (K), L202.1, Q201.2 (S), R203.1, U201.3 (VI), U204.5 (VIN), U205.5 (BAT)
/Power/USB_CC1: J202.A5 (CC1), R204.2, U202.1 (I/O)
/Power/USB_CC2: J202.B5 (CC2), R205.2, U203.1 (I/O)
GND: C201.2, C202.2, C203.2, C204.2, C206.2, C207.2, C208.2, D202.2 (A2), J201.1, J202.A12 (GND), J202.B12 (GND), J202.S1 (SHIELD), R201.2, R204.1, R205.1, R206.2, R209.2, R210.2, R211.2, R212.2, TP201.1, U201.1 (GND), U202.2 (GND), U203.2 (GND), U204.2 (GND), U205.1 (TEMP), U205.3 (GND), U205.9 (EPAD); also elsewhere on the board
unnamed: D201.2 (A), Q201.1 (G), R201.1
unnamed: D202.1 (A1), J202.A9 (VBUS), J202.B9 (VBUS), L201.1
unnamed: D203.2 (A), L202.2, U204.1 (SW)
unnamed: D204.1 (K), R208.2
unnamed: J201.2, SW202.2 (B)
unnamed: Q201.3 (D), SW202.3 (C)
unnamed: R209.1, SW201.1
unnamed: R210.1, SW201.2
unnamed: R211.1, SW201.3
unnamed: R212.1, SW201.4
unnamed: R203.2, U204.4 (EN)
unnamed: C205.2, R202.2, R206.1, U204.3 (FB)
unnamed: R207.1, U205.8 (CE)
unnamed: SW201.5, SW201.6, SW201.7, SW201.8, U205.2 (PROG)
unnamed: R208.1, U205.7 (~CHRG)
VBUS: C208.1, D204.2 (A), L201.2, R207.2, U205.4 (V_{CC})

Notes on the sheet:
RPROG= IBAT 30k = 50mA 20k = 70mA 10k = 130mA * 5k = 250mA 4k = 300mA * 3k = 400mA 2k = 580mA * 1.6k = 690mA 1.4k = 780mA 1.2k = 900mA * 1.1k = 1000mA
Compatible with EEMB 3.7V Lipo Battery Verify battery connector polarity
Vout = 1.233 * (1 + R1/R2)
