valletw/busy-board/kicad/busy-board.kicad_pcb

## KiCad design kicad/busy-board.kicad_pcb (continued)

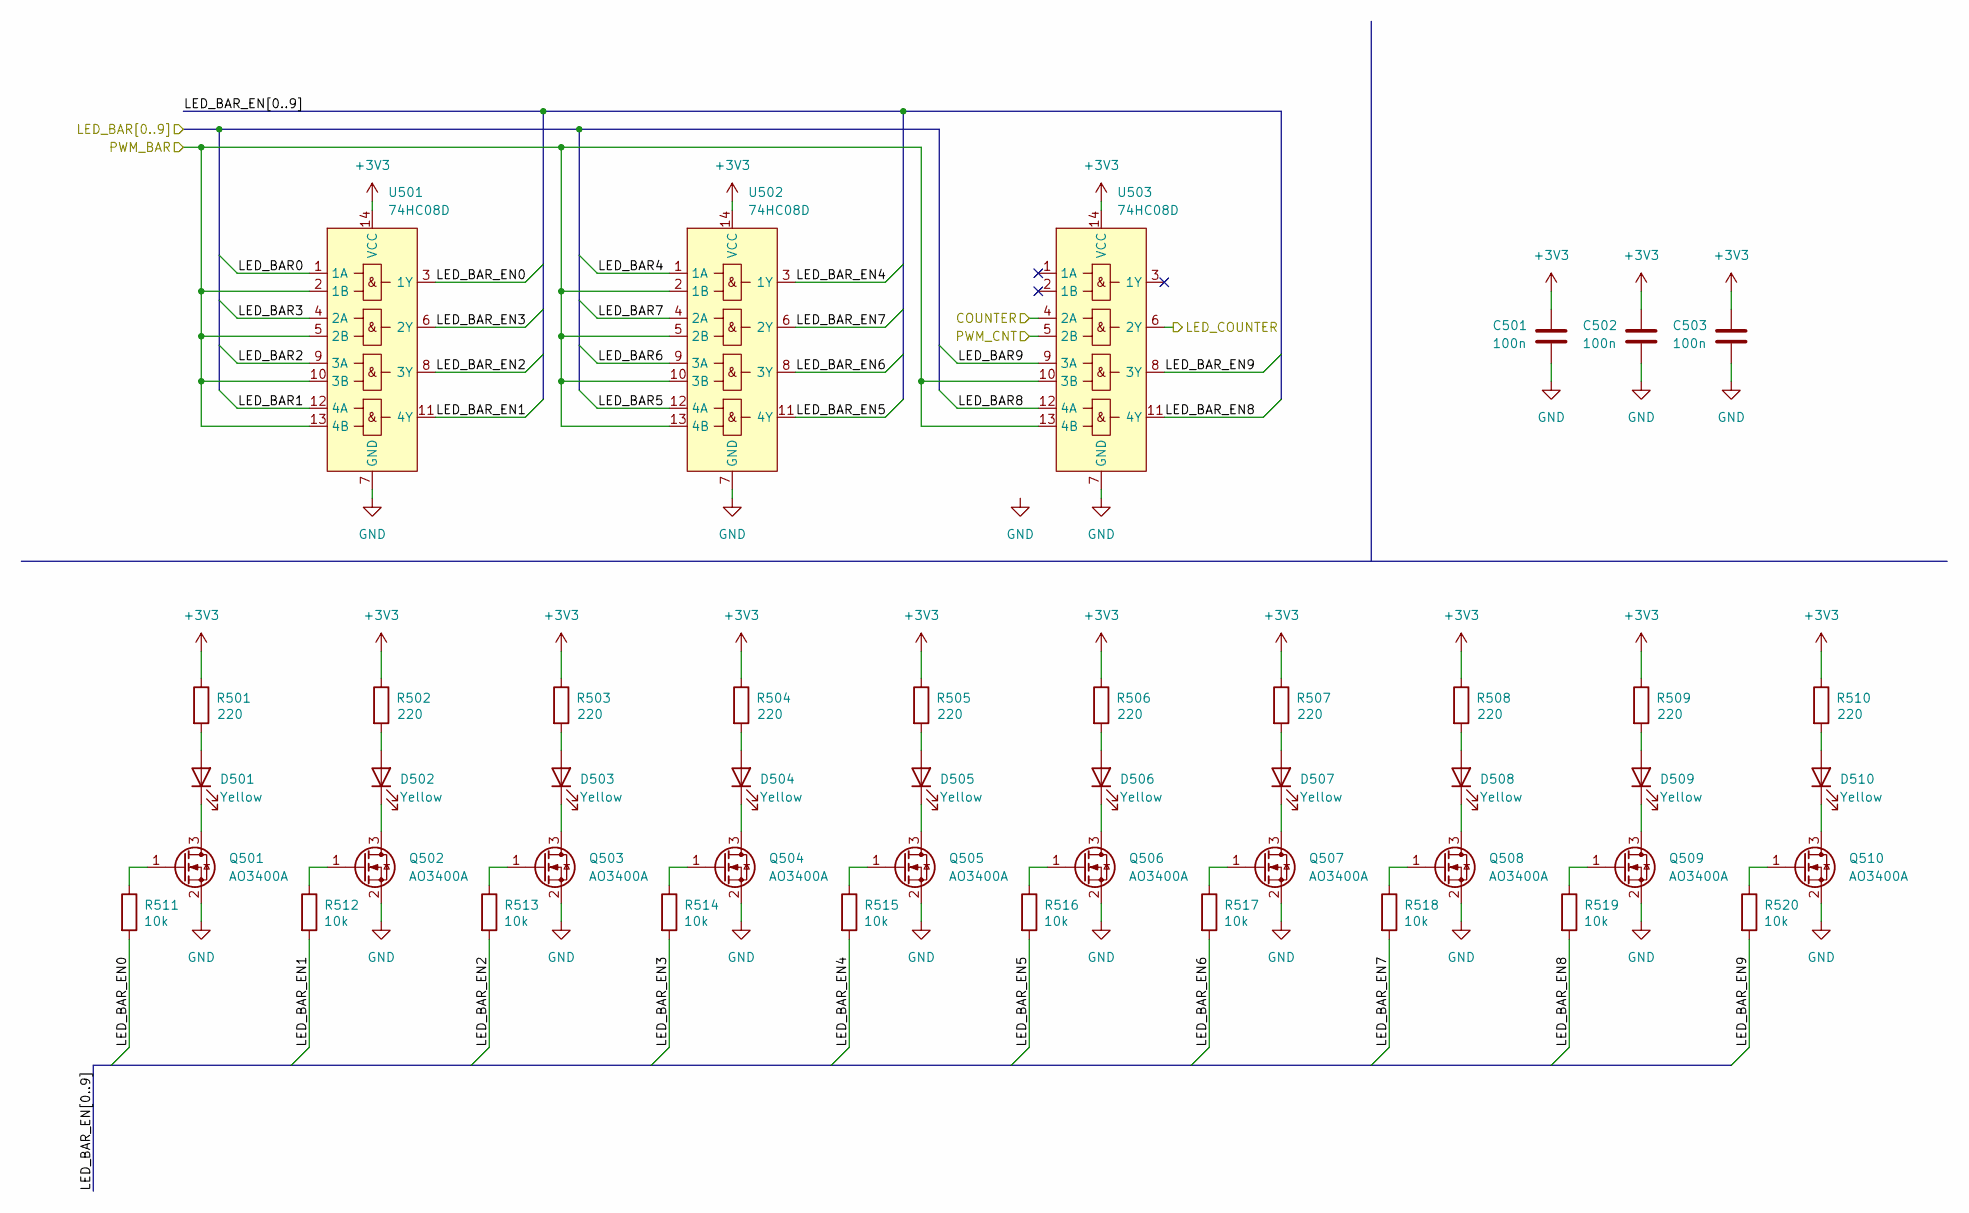
[picture p14: schematic display_bar.kicad_sch, Busy Board]

Parts:
C501, C502, C503: 100n; C_0402_1005Metric; MFR Part # CL05B104KB54PNC; LCSC Part # C307331
D501, D502, D503, D504, D505, D506, D507, D508, D509, D510: Yellow; LED_0805_2012Metric; MFR Part # KT-0805Y; LCSC Part # C2296
Q501, Q502, Q503, Q504, Q505, Q506, Q507, Q508, Q509, Q510: AO3400A; SOT-23; MFR Part # AO3400A; LCSC Part # C20917
R501, R502, R503, R504, R505, R506, R507, R508, R509, R510: 220; R_0603_1608Metric; MFR Part # 0603WAF2200T5E; LCSC Part # C22962
R511, R512, R513, R514, R515, R516, R517, R518, R519, R520: 10k; R_0603_1608Metric; MFR Part # 0603WAF1002T5E; LCSC Part # C25804
U501, U502, U503: 74HC08D; SOIC-14_3.9x8.7mm_P1.27mm; MFR Part # 74HC08D,653; LCSC Part # C5593

Connections:
+3V3: C501.1, C502.1, C503.1, R501.1, R502.1, R503.1, R504.1, R505.1, R506.1, R507.1, R508.1, R509.1, R510.1, U501.14 (VCC), U502.14 (VCC), U503.14 (VCC); also elsewhere on the board
/CLK_CNT: U503.4 (2A); also elsewhere on the board
/Counter/Display Bar/LED_BAR_EN0: R511.2, U501.3 (1Y)
/Counter/Display Bar/LED_BAR_EN1: R512.2, U501.11 (4Y)
/Counter/Display Bar/LED_BAR_EN2: R513.2, U501.8 (3Y)
/Counter/Display Bar/LED_BAR_EN3: R514.2, U501.6 (2Y)
/Counter/Display Bar/LED_BAR_EN4: R515.2, U502.3 (1Y)
/Counter/Display Bar/LED_BAR_EN5: R516.2, U502.11 (4Y)
/Counter/Display Bar/LED_BAR_EN6: R517.2, U502.8 (3Y)
/Counter/Display Bar/LED_BAR_EN7: R518.2, U502.6 (2Y)
/Counter/Display Bar/LED_BAR_EN8: R519.2, U503.11 (4Y)
/Counter/Display Bar/LED_BAR_EN9: R520.2, U503.8 (3Y)
/Counter/LED_BAR0: U501.1 (1A); also elsewhere on the board
/Counter/LED_BAR1: U501.12 (4A); also elsewhere on the board
/Counter/LED_BAR2: U501.9 (3A); also elsewhere on the board
/Counter/LED_BAR3: U501.4 (2A); also elsewhere on the board
/Counter/LED_BAR4: U502.1 (1A); also elsewhere on the board
/Counter/LED_BAR5: U502.12 (4A); also elsewhere on the board
/Counter/LED_BAR6: U502.9 (3A); also elsewhere on the board
/Counter/LED_BAR7: U502.4 (2A); also elsewhere on the board
/Counter/LED_BAR8: U503.12 (4A); also elsewhere on the board
/Counter/LED_BAR9: U503.9 (3A); also elsewhere on the board
/Counter/LED_COUNTER: U503.6 (2Y); also elsewhere on the board
/Counter/PWM_LED_BAR: U501.2 (1B), U501.5 (2B), U501.10 (3B), U501.13 (4B), U502.2 (1B), U502.5 (2B), U502.10 (3B), U502.13 (4B), U503.10 (3B), U503.13 (4B); also elsewhere on the board
/Counter/PWM_LED_COUNTER: U503.5 (2B); also elsewhere on the board
GND: C501.2, C502.2, C503.2, Q501.2 (S), Q502.2 (S), Q503.2 (S), Q504.2 (S), Q505.2 (S), Q506.2 (S), Q507.2 (S), Q508.2 (S), Q509.2 (S), Q510.2 (S), U501.7 (GND), U502.7 (GND), U503.7 (GND); also elsewhere on the board
unnamed: D501.2 (A), R501.2
unnamed: D501.1 (K), Q501.3 (D)
unnamed: D502.2 (A), R502.2
unnamed: D502.1 (K), Q502.3 (D)
unnamed: D503.2 (A), R503.2
unnamed: D503.1 (K), Q503.3 (D)
unnamed: D504.2 (A), R504.2
unnamed: D504.1 (K), Q504.3 (D)
unnamed: D505.2 (A), R505.2
unnamed: D505.1 (K), Q505.3 (D)
unnamed: D506.2 (A), R506.2
unnamed: D506.1 (K), Q506.3 (D)
unnamed: D507.2 (A), R507.2
unnamed: D507.1 (K), Q507.3 (D)
unnamed: D508.2 (A), R508.2
unnamed: D508.1 (K), Q508.3 (D)
unnamed: D509.2 (A), R509.2
unnamed: D509.1 (K), Q509.3 (D)
unnamed: D510.2 (A), R510.2
unnamed: D510.1 (K), Q510.3 (D)
unnamed: Q501.1 (G), R511.1
unnamed: Q502.1 (G), R512.1
unnamed: Q503.1 (G), R513.1
unnamed: Q504.1 (G), R514.1
unnamed: Q505.1 (G), R515.1
unnamed: Q506.1 (G), R516.1
unnamed: Q507.1 (G), R517.1
unnamed: Q508.1 (G), R518.1
unnamed: Q509.1 (G), R519.1
unnamed: Q510.1 (G), R520.1

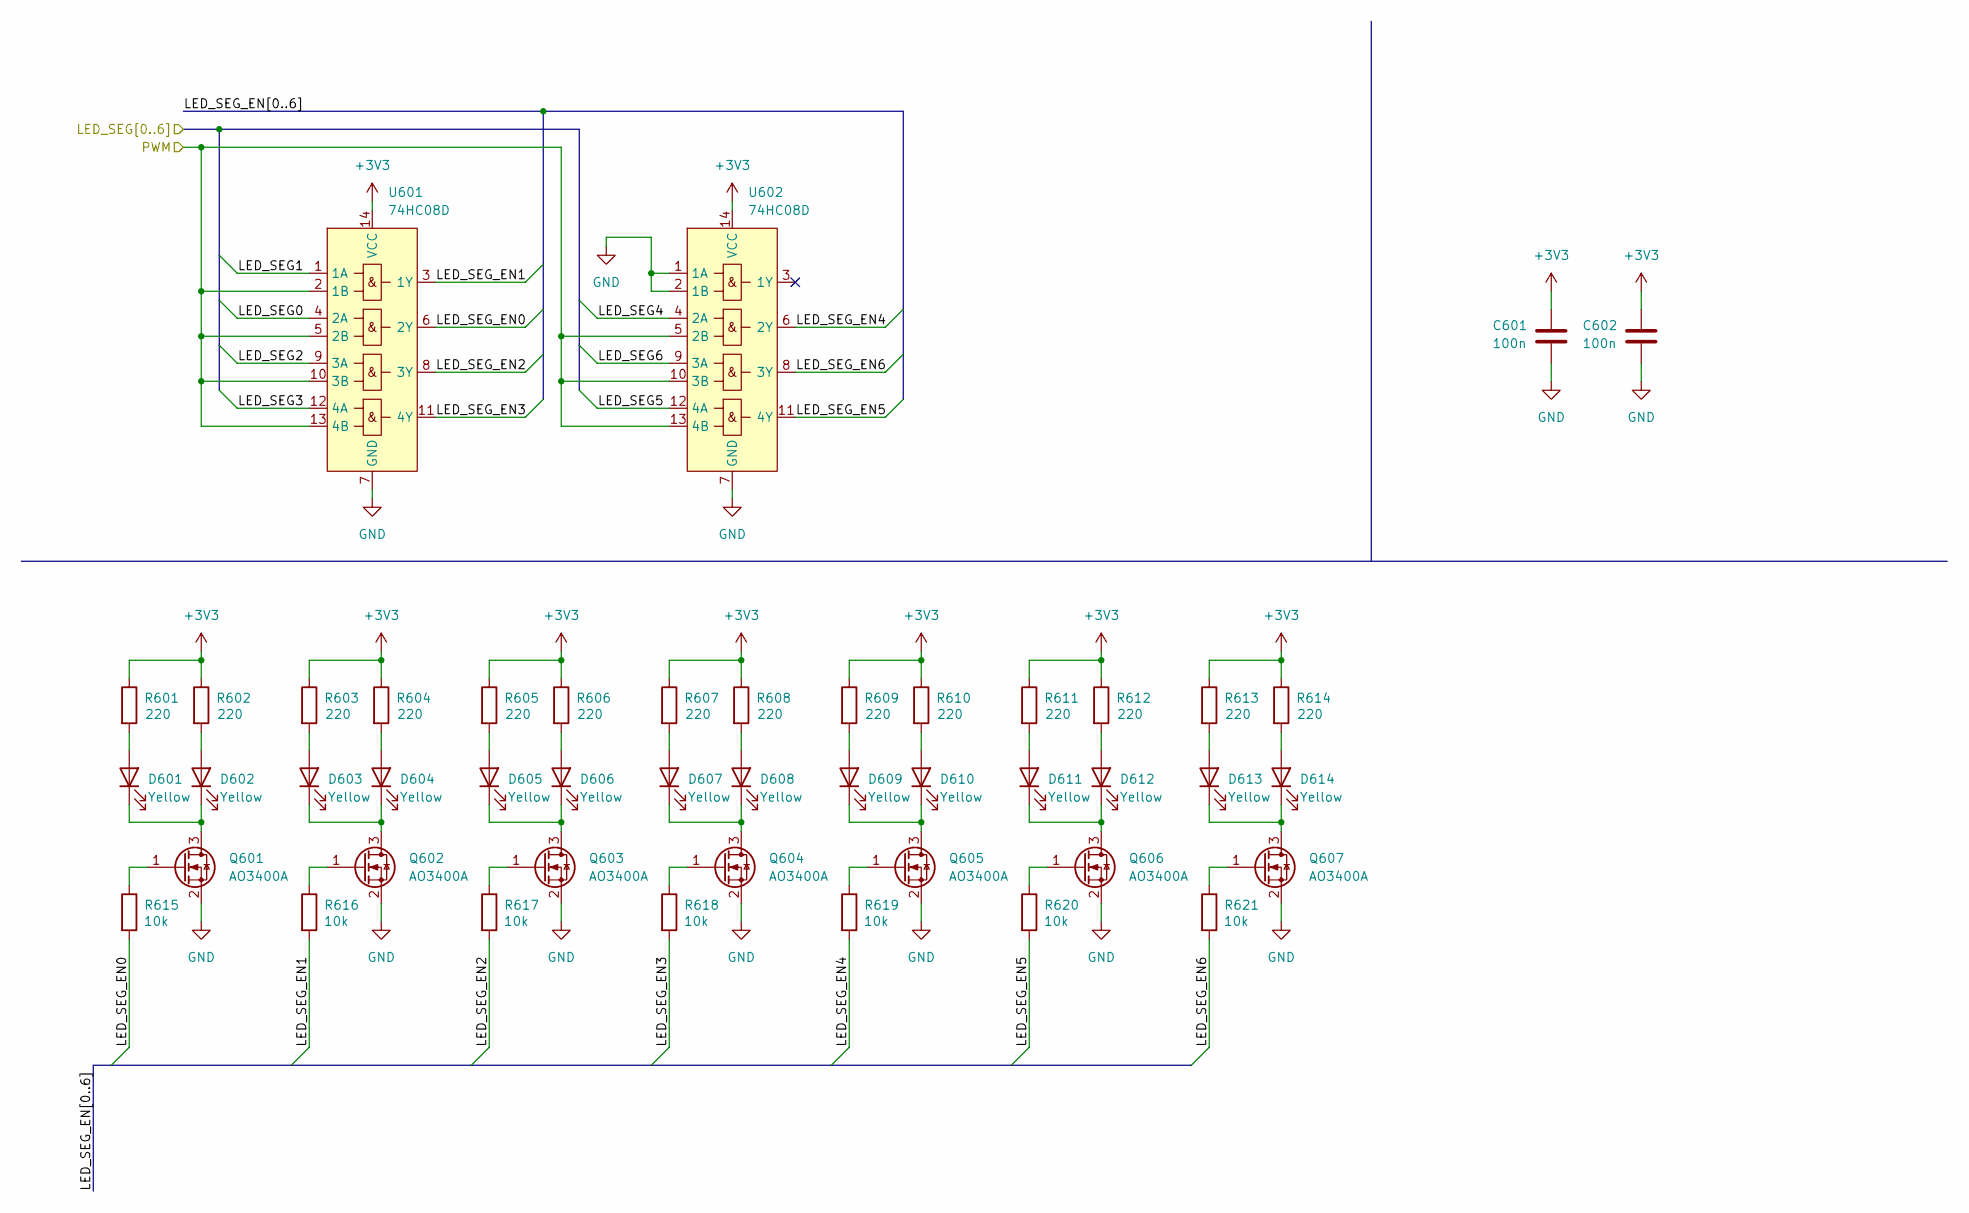
[picture p15: schematic display_7seg.kicad_sch, Busy Board]

Parts:
C601, C602: 100n; C_0402_1005Metric; MFR Part # CL05B104KB54PNC; LCSC Part # C307331
D601, D602, D603, D604, D605, D606, D607, D608, D609, D610, D611, D612, D613, D614: Yellow; LED_0805_2012Metric; MFR Part # KT-0805Y; LCSC Part # C2296
Q601, Q602, Q603, Q604, Q605, Q606, Q607: AO3400A; SOT-23; MFR Part # AO3400A; LCSC Part # C20917
R601, R602, R603, R604, R605, R606, R607, R608, R609, R610, R611, R612, R613, R614: 220; R_0603_1608Metric; MFR Part # 0603WAF2200T5E; LCSC Part # C22962
R615, R616, R617, R618, R619, R620, R621: 10k; R_0603_1608Metric; MFR Part # 0603WAF1002T5E; LCSC Part # C25804
U601, U602: 74HC08D; SOIC-14_3.9x8.7mm_P1.27mm; MFR Part # 74HC08D,653; LCSC Part # C5593

Connections:
+3V3: C601.1, C602.1, R601.1, R602.1, R603.1, R604.1, R605.1, R606.1, R607.1, R608.1, R609.1, R610.1, R611.1, R612.1, R613.1, R614.1, U601.14 (VCC), U602.14 (VCC); also elsewhere on the board
/Counter/Display 7 Segments/LED_SEG_EN0: R615.2, U601.6 (2Y)
/Counter/Display 7 Segments/LED_SEG_EN1: R616.2, U601.3 (1Y)
/Counter/Display 7 Segments/LED_SEG_EN2: R617.2, U601.8 (3Y)
/Counter/Display 7 Segments/LED_SEG_EN3: R618.2, U601.11 (4Y)
/Counter/Display 7 Segments/LED_SEG_EN4: R619.2, U602.6 (2Y)
/Counter/Display 7 Segments/LED_SEG_EN5: R620.2, U602.11 (4Y)
/Counter/Display 7 Segments/LED_SEG_EN6: R621.2, U602.8 (3Y)
/Counter/LED_SEG0: U601.4 (2A); also elsewhere on the board
/Counter/LED_SEG1: U601.1 (1A); also elsewhere on the board
/Counter/LED_SEG2: U601.9 (3A); also elsewhere on the board
/Counter/LED_SEG3: U601.12 (4A); also elsewhere on the board
/Counter/LED_SEG4: U602.4 (2A); also elsewhere on the board
/Counter/LED_SEG5: U602.12 (4A); also elsewhere on the board
/Counter/LED_SEG6: U602.9 (3A); also elsewhere on the board
/Counter/PWM_LED_SEG: U601.2 (1B), U601.5 (2B), U601.10 (3B), U601.13 (4B), U602.5 (2B), U602.10 (3B), U602.13 (4B); also elsewhere on the board
GND: C601.2, C602.2, Q601.2 (S), Q602.2 (S), Q603.2 (S), Q604.2 (S), Q605.2 (S), Q606.2 (S), Q607.2 (S), U601.7 (GND), U602.1 (1A), U602.2 (1B), U602.7 (GND); also elsewhere on the board
unnamed: D601.2 (A), R601.2
unnamed: D601.1 (K), D602.1 (K), Q601.3 (D)
unnamed: D602.2 (A), R602.2
unnamed: D603.2 (A), R603.2
unnamed: D603.1 (K), D604.1 (K), Q602.3 (D)
unnamed: D604.2 (A), R604.2
unnamed: D605.2 (A), R605.2
unnamed: D605.1 (K), D606.1 (K), Q603.3 (D)
unnamed: D606.2 (A), R606.2
unnamed: D607.2 (A), R607.2
unnamed: D607.1 (K), D608.1 (K), Q604.3 (D)
unnamed: D608.2 (A), R608.2
unnamed: D609.2 (A), R609.2
unnamed: D609.1 (K), D610.1 (K), Q605.3 (D)
unnamed: D610.2 (A), R610.2
unnamed: D611.2 (A), R611.2
unnamed: D611.1 (K), D612.1 (K), Q606.3 (D)
unnamed: D612.2 (A), R612.2
unnamed: D613.2 (A), R613.2
unnamed: D613.1 (K), D614.1 (K), Q607.3 (D)
unnamed: D614.2 (A), R614.2
unnamed: Q601.1 (G), R615.1
unnamed: Q602.1 (G), R616.1
unnamed: Q603.1 (G), R617.1
unnamed: Q604.1 (G), R618.1
unnamed: Q605.1 (G), R619.1
unnamed: Q606.1 (G), R620.1
unnamed: Q607.1 (G), R621.1

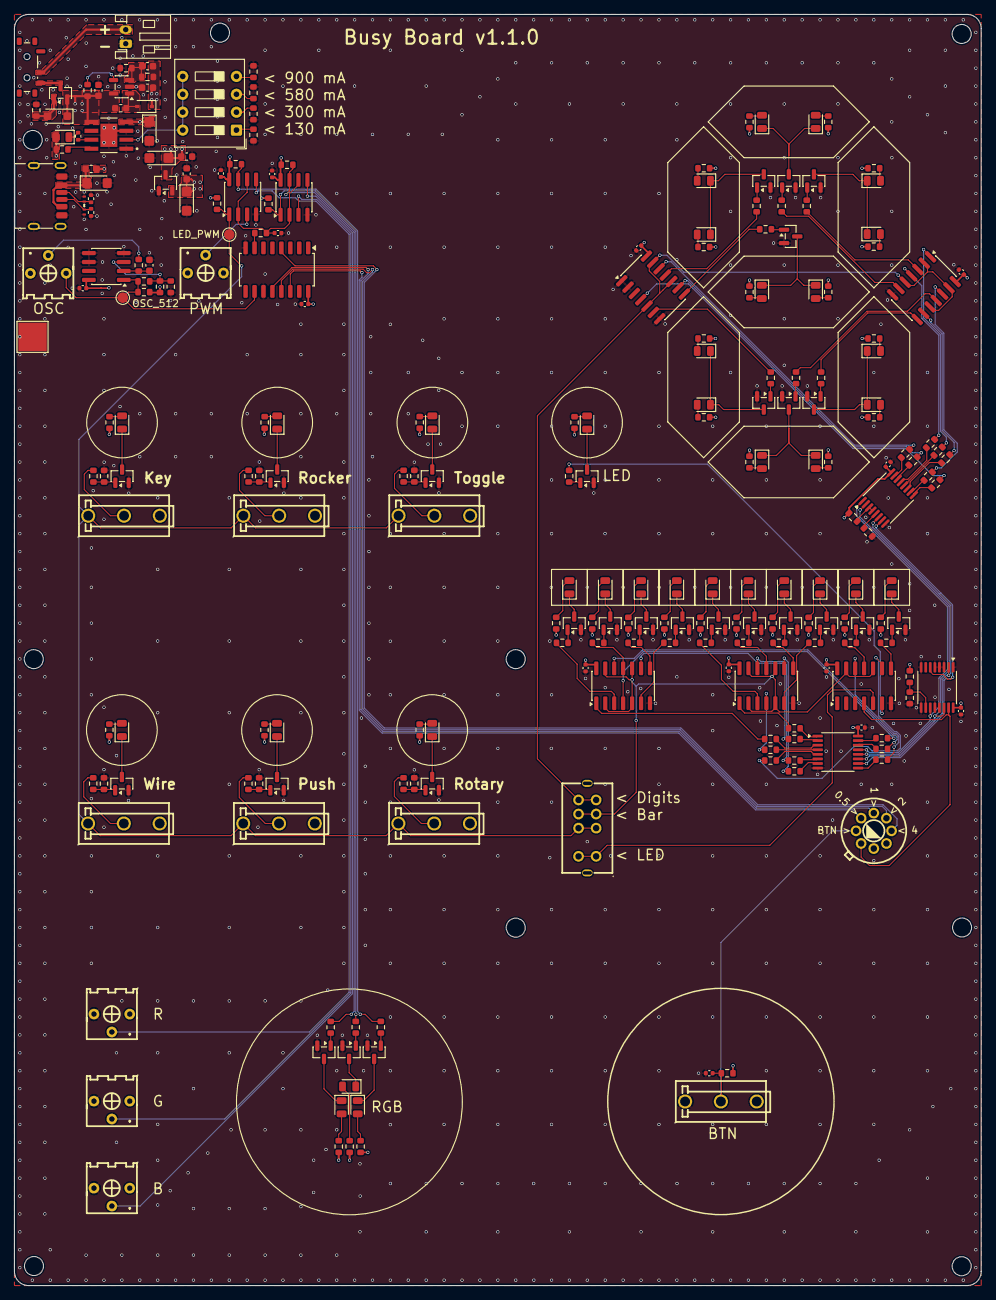
[picture p16: board busy-board.kicad_pcb from above]

Board: 4 copper layers, 137.2 x 180.3 mm, 249 parts (0 on the bottom side), 198 nets.
