valletw/busy-board/(commit log)

2026-08-28 Add Kicad project
    [busy-board.kicad_pcb, busy-board.kicad_sch, counter.kicad_sch, display_7seg.kicad_sch, display_bar.kicad_sch, led.kicad_sch, power.kicad_sch]
2026-08-28 Add manufacturing files
    [bom-extended.csv, bom-full.csv, bom-partial.csv, bom.csv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]
2026-09-27 Fix v1 issues
    - Change BJT to MOSFET for LED control: voltage drop on PWM
    - Change voltage switch to PWM switch for 7-seg and bar control
    - Change LDO to limit drop-out with battery
    - Decrease resistor on Purple LED to increase luminosity
    [busy-board.kicad_pcb, busy-board.kicad_sch, counter.kicad_sch, display_7seg.kicad_sch, display_bar.kicad_sch, led.kicad_sch, power.kicad_sch]
2026-09-27 Update manufacturing files
    [bom-full.csv, bom.csv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]
