valletw/busy-board/(notices)

Notices in the files:
kicad/busy-board.kicad_pcb:
MIT License
